zephray/Sharket/pcb/mainboard/pcb.kicad_pcb

## KiCad design pcb/mainboard/pcb.kicad_pcb (2023-03-07)

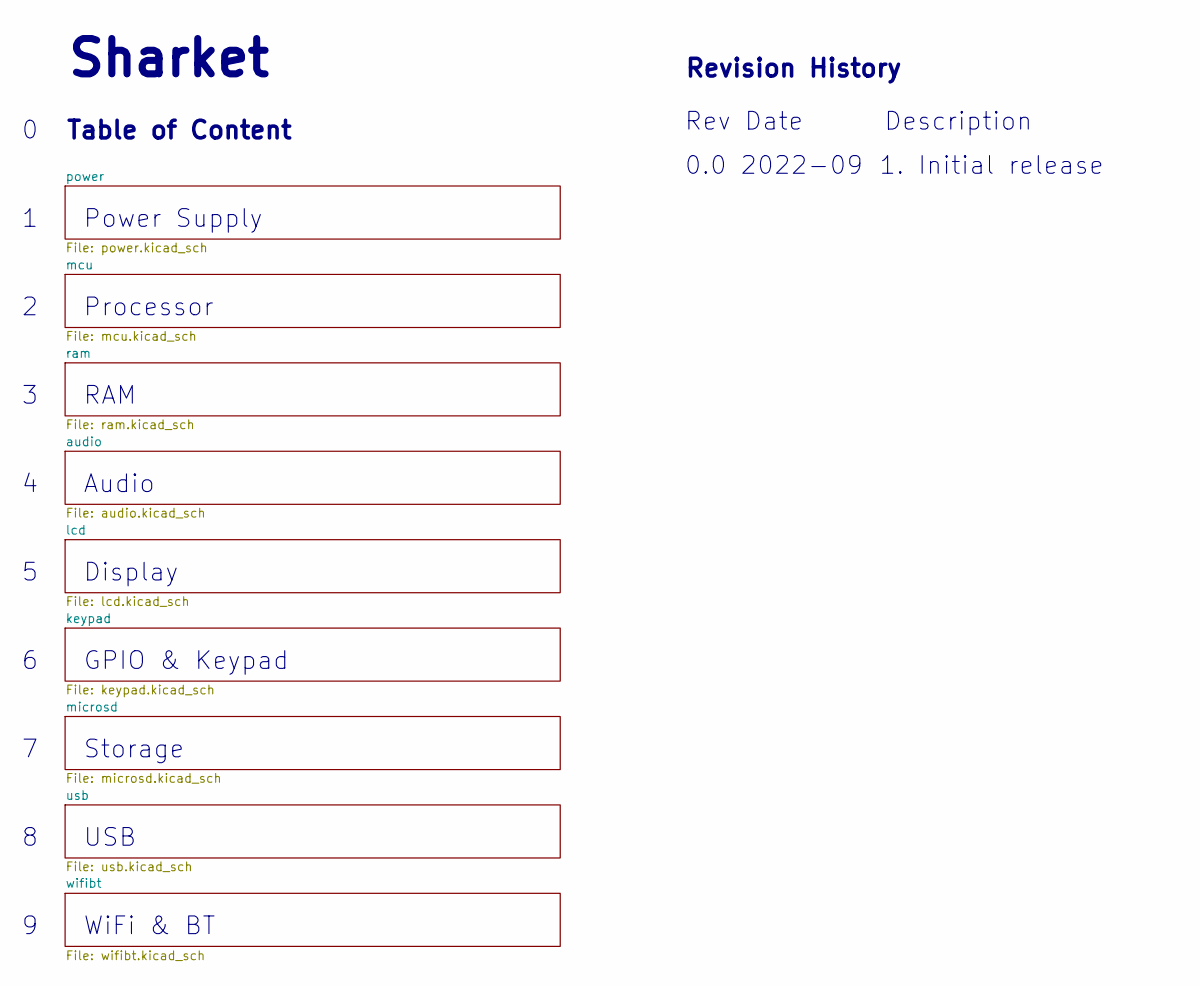
[picture p1: schematic pcb.kicad_sch, Sharket]

Notes on the sheet:
Storage
WiFi & BT
0.0 2022-09
Processor
Display
Revision History
Power Supply
Sharket
GPIO & Keypad
USB
Table of Content
RAM
Rev Date Description
Audio
1. Initial release

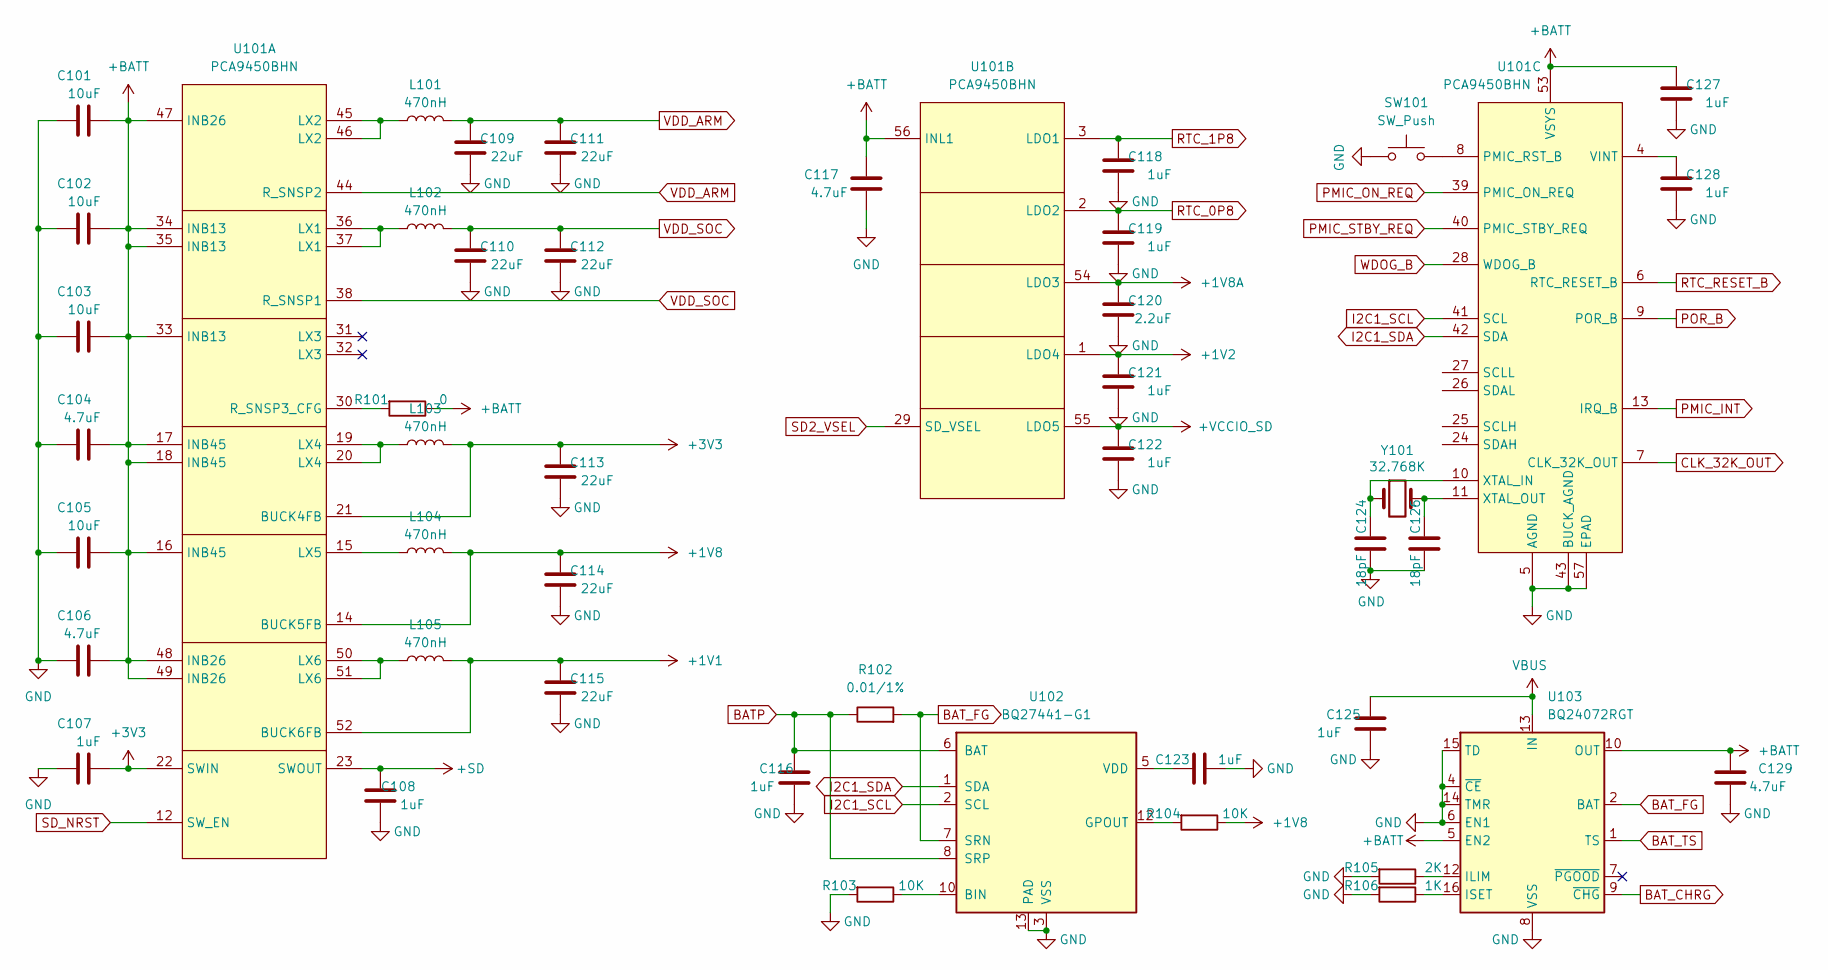
[picture p2: schematic power.kicad_sch, Sharket]

Parts:
C101, C102, C103, C105: 10uF; C_0603_1608Metric
C104, C106, C117, C129: 4.7uF; C_0402_1005Metric
C107, C108, C116, C123: 1uF; C_0402_1005Metric
C109, C110, C111, C112, C113, C114, C115: 22uF; C_0603_1608Metric
C118, C119, C121, C122, C125, C127, C128: 1uF; C_0201_0603Metric
C120: 2.2uF; C_0402_1005Metric
C124, C126: 18pF; C_0402_1005Metric
L101, L102, L103, L104, L105: 470nH; L_1008_2520Metric
R101: 0; R_0402_1005Metric
R102: 0.01/1%; R_0603_1608Metric
R103, R104: 10K; R_0402_1005Metric
R105: 2K; R_0402_1005Metric
R106: 1K; R_0402_1005Metric
SW101: SW_Push; SW_SPST_SKQG_WithStem
U101: PCA9450BHN; QFN-56_EP_7x7_Pitch0.4mm
U102: BQ27441-G1; Texas_S-PDSO-N12
U103: BQ24072RGT; VQFN-16-1EP_3x3mm_P0.5mm_EP1.6x1.6mm
Y101: 32.768K; Crystal_SMD_TXC_9HT11-2Pin_2.0x1.2mm_HandSoldering

Connections:
+1V1: C115.2, L105.2, U101.52 (BUCK6FB); also elsewhere on the board
+1V2: C121.2, U101.1 (LDO4); also elsewhere on the board
+1V8: C114.2, L104.2, R104.1, U101.14 (BUCK5FB); also elsewhere on the board
+1V8A: C120.2, U101.54 (LDO3); also elsewhere on the board
+3V3: C107.2, C113.2, L103.2, U101.21 (BUCK4FB), U101.22 (SWIN); also elsewhere on the board
+BATT: C101.2, C102.2, C103.2, C104.2, C105.2, C106.2, C117.2, C127.2, C129.2, R101.1, U101.16 (INB45), U101.17 (INB45), U101.18 (INB45), U101.33 (INB13), U101.34 (INB13), U101.35 (INB13), U101.47 (INB26), U101.48 (INB26), U101.49 (INB26), U101.53 (VSYS), U101.56 (INL1), U103.5 (EN2), U103.10 (OUT), U103.11 (OUT); also elsewhere on the board
+SD: C108.2, U101.23 (SWOUT); also elsewhere on the board
+VCCIO_SD: C122.2, U101.55 (LDO5); also elsewhere on the board
BATP: C116.2, R102.1, U102.6 (BAT), U102.8 (SRP); also elsewhere on the board
BAT_CHRG: U103.9 (~CHG)
BAT_FG: R102.2, U102.7 (SRN), U103.2 (BAT), U103.3 (BAT)
BAT_TS: U103.1 (TS)
CLK_32K_OUT: U101.7 (CLK_32K_OUT); also elsewhere on the board
GND: C101.1, C102.1, C103.1, C104.1, C105.1, C106.1, C107.1, C108.1, C109.1, C110.1, C111.1, C112.1, C113.1, C114.1, C115.1, C116.1, C117.1, C118.1, C119.1, C120.1, C121.1, C122.1, C123.1, C124.1, C125.1, C126.1, C127.1, C128.1, C129.1, R103.2, R105.2, R106.2, SW101.1, U101.5 (AGND), U101.43 (BUCK_AGND), U101.57 (EPAD), U102.3 (VSS), U102.13 (PAD), U103.4 (~CE), U103.6 (EN1), U103.8 (VSS), U103.14 (TMR), U103.15 (TD), U103.17 (VSS); also elsewhere on the board
I2C1_SCL: U101.41 (SCL), U102.2 (SCL); also elsewhere on the board
I2C1_SDA: U101.42 (SDA), U102.1 (SDA); also elsewhere on the board
unnamed: L101.1, U101.45 (LX2), U101.46 (LX2)
unnamed: L102.1, U101.36 (LX1), U101.37 (LX1)
unnamed: L103.1, U101.19 (LX4), U101.20 (LX4)
unnamed: L105.1, U101.50 (LX6), U101.51 (LX6)
unnamed: L104.1, U101.15 (LX5)
unnamed: R101.2, U101.30 (R_SNSP3_CFG)
unnamed: SW101.2, U101.8 (PMIC_RST_B)
unnamed: C128.2, U101.4 (VINT)
unnamed: C124.2, U101.10 (XTAL_IN), Y101.1
unnamed: C126.2, U101.11 (XTAL_OUT), Y101.2
unnamed: R103.1, U102.10 (BIN)
unnamed: R104.2, U102.12 (GPOUT)
unnamed: C123.2, U102.5 (VDD)
unnamed: R105.1, U103.12 (ILIM)
unnamed: R106.1, U103.16 (ISET)
PMIC_INT: U101.13 (IRQ_B); also elsewhere on the board
PMIC_ON_REQ: U101.39 (PMIC_ON_REQ); also elsewhere on the board
PMIC_STBY_REQ: U101.40 (PMIC_STBY_REQ); also elsewhere on the board
POR_B: U101.9 (POR_B); also elsewhere on the board
RTC_0P8: C119.2, U101.2 (LDO2); also elsewhere on the board
RTC_1P8: C118.2, U101.3 (LDO1); also elsewhere on the board
RTC_RESET_B: U101.6 (RTC_RESET_B); also elsewhere on the board
SD2_VSEL: U101.29 (SD_VSEL); also elsewhere on the board
SD_NRST: U101.12 (SW_EN); also elsewhere on the board
VBUS: C125.2, U103.13 (IN); also elsewhere on the board
VDD_ARM: C109.2, C111.2, L101.2, U101.44 (R_SNSP2); also elsewhere on the board
VDD_SOC: C110.2, C112.2, L102.2, U101.38 (R_SNSP1); also elsewhere on the board
WDOG_B: U101.28 (WDOG_B); also elsewhere on the board

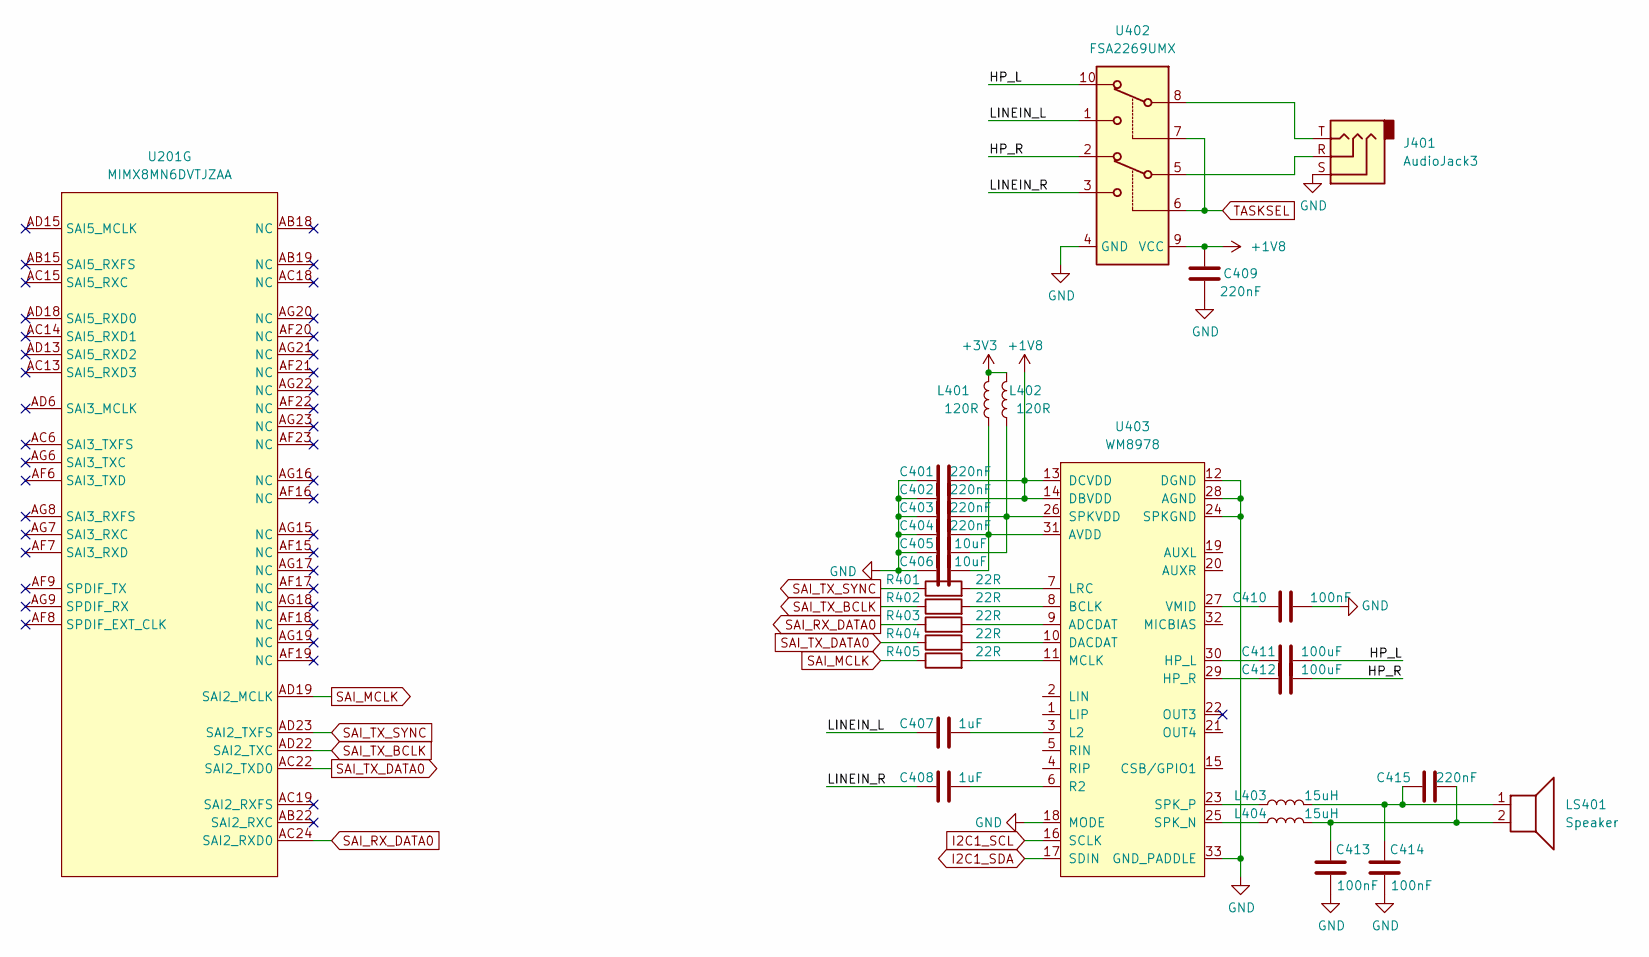
[picture p3: schematic audio.kicad_sch, Sharket]

Parts:
C401, C402, C403, C404, C409, C415: 220nF; C_0201_0603Metric; LCSC C880414
C405, C406: 10uF; C_0402_1005Metric; LCSC C105490
C407, C408: 1uF; C_0402_1005Metric; LCSC C157353
C410, C413, C414: 100nF; C_0201_0603Metric; LCSC C56392
C411, C412: 100uF; C_1206_3216Metric; LCSC C178304
J401: AudioJack3; PJ-208
L401, L402: 120R; L_0603_1608Metric; LCSC C76892
L403, L404: 15uH; L_0603_1608Metric; LCSC C486329
LS401: Speaker; Buzzer_CUI_CPT-9019S-SMT
R401, R402, R403, R404, R405: 22R; R_0402_1005Metric; LCSC C93929
U201: MIMX8MN6DVTJZAA; BGA-486_27x27_14.0x14.0mm
U402: FSA2269UMX; UQFN-10_1.4x1.8mm_P0.4mm
U403: WM8978; QFN-32-1EP_5x5mm_P0.5mm_EP3.45x3.45mm_ThermalVias

Connections:
+1V8: C401.1, C402.1, C409.1, U402.9 (VCC), U403.13 (DCVDD), U403.14 (DBVDD); also elsewhere on the board
+3V3: L401.2, L402.2; also elsewhere on the board
/audio/HP_L: C411.2, U402.10
/audio/HP_R: C412.2, U402.2
/audio/LINEIN_L: C407.2, U402.1
/audio/LINEIN_R: C408.2, U402.3
GND: C401.2, C402.2, C403.2, C404.2, C405.2, C406.2, C409.2, C410.2, C413.1, C414.1, J401.S, U402.4 (GND), U403.12 (DGND), U403.18 (MODE), U403.24 (SPKGND), U403.28 (AGND), U403.33 (GND_PADDLE); also elsewhere on the board
I2C1_SCL: U403.16 (SCLK); also elsewhere on the board
I2C1_SDA: U403.17 (SDIN); also elsewhere on the board
unnamed: C413.2, C415.2, L404.2, LS401.2
unnamed: C414.2, C415.1, L403.2, LS401.1
unnamed: J401.R, U402.5
unnamed: J401.T, U402.8
unnamed: R403.2, U403.9 (ADCDAT)
unnamed: C404.1, C406.1, L401.1, U403.31 (AVDD)
unnamed: R402.2, U403.8 (BCLK)
unnamed: R404.2, U403.10 (DACDAT)
unnamed: C411.1, U403.30 (HP_L)
unnamed: C412.1, U403.29 (HP_R)
unnamed: C407.1, U403.3 (L2)
unnamed: R401.2, U403.7 (LRC)
unnamed: R405.2, U403.11 (MCLK)
unnamed: C408.1, U403.6 (R2)
unnamed: C403.1, C405.1, L402.1, U403.26 (SPKVDD)
unnamed: L404.1, U403.25 (SPK_N)
unnamed: L403.1, U403.23 (SPK_P)
unnamed: C410.1, U403.27 (VMID)
SAI_MCLK: R405.1, U201.AD19 (SAI2_MCLK)
SAI_RX_DATA0: R403.1, U201.AC24 (SAI2_RXD0)
SAI_TX_BCLK: R402.1, U201.AD22 (SAI2_TXC)
SAI_TX_DATA0: R404.1, U201.AC22 (SAI2_TXD0)
SAI_TX_SYNC: R401.1, U201.AD23 (SAI2_TXFS)
TASKSEL: U402.6, U402.7; also elsewhere on the board

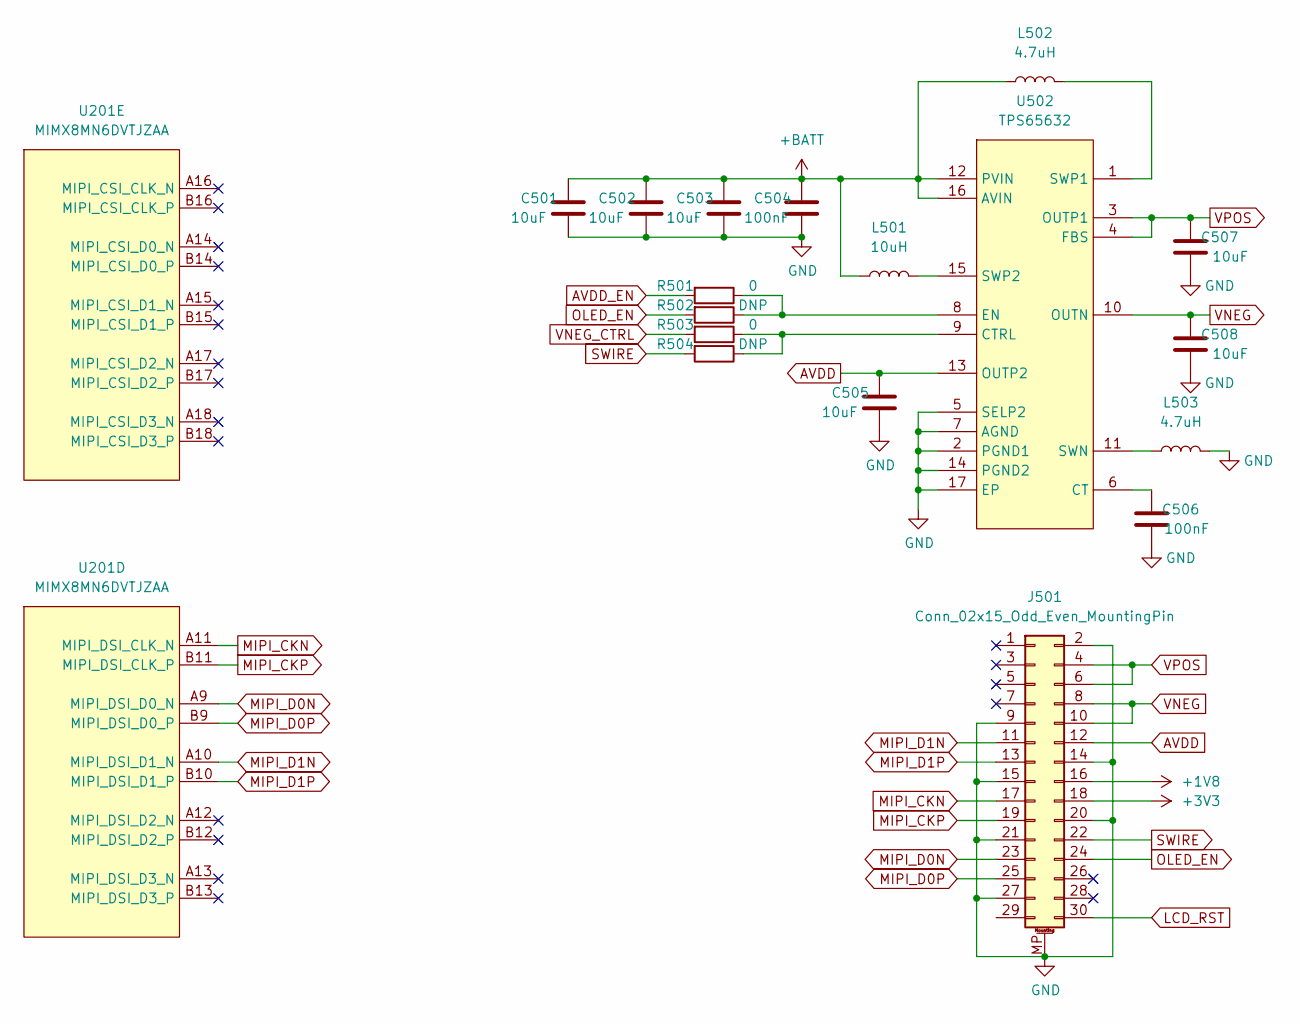
[picture p4: schematic lcd.kicad_sch, Sharket]

Parts:
C501, C502, C503, C505, C507, C508: 10uF; C_0603_1608Metric
C504, C506: 100nF; C_0201_0603Metric
J501: Conn_02x15_Odd_Even_MountingPin; 505270-3012
L501: 10uH; L_1008_2520Metric
L502, L503: 4.7uH; L_1008_2520Metric
R501, R503: 0; R_0402_1005Metric
R502, R504: DNP; R_0402_1005Metric
U201: MIMX8MN6DVTJZAA; BGA-486_27x27_14.0x14.0mm
U502: TPS65632; QFN-16-1EP_3x3mm_P0.5mm_EP1.7x1.7mm

Connections:
+1V8: J501.16; also elsewhere on the board
+3V3: J501.18; also elsewhere on the board
+BATT: C501.2, C502.2, C503.2, C504.2, L501.1, L502.1, U502.12 (PVIN), U502.16 (AVIN); also elsewhere on the board
AVDD: C505.2, J501.12, U502.13 (OUTP2)
AVDD_EN: R501.2; also elsewhere on the board
GND: C501.1, C502.1, C503.1, C504.1, C505.1, C506.1, C507.1, C508.1, J501.2, J501.9, J501.14, J501.15, J501.20, J501.21, J501.27, J501.MP (MountPin), L503.2, U502.2 (PGND1), U502.5 (SELP2), U502.7 (AGND), U502.14 (PGND2), U502.17 (EP); also elsewhere on the board
LCD_RST: J501.30; also elsewhere on the board
MIPI_CKN: J501.17, U201.A11 (MIPI_DSI_CLK_N)
MIPI_CKP: J501.19, U201.B11 (MIPI_DSI_CLK_P)
MIPI_D0N: J501.23, U201.A9 (MIPI_DSI_D0_N)
MIPI_D0P: J501.25, U201.B9 (MIPI_DSI_D0_P)
MIPI_D1N: J501.11, U201.A10 (MIPI_DSI_D1_N)
MIPI_D1P: J501.13, U201.B10 (MIPI_DSI_D1_P)
unnamed: C506.2, U502.6 (CT)
unnamed: R503.1, R504.1, U502.9 (CTRL)
unnamed: R501.1, R502.1, U502.8 (EN)
unnamed: L503.1, U502.11 (SWN)
unnamed: L502.2, U502.1 (SWP1)
unnamed: L501.2, U502.15 (SWP2)
OLED_EN: J501.24, R502.2
SWIRE: J501.22, R504.2
VNEG: C508.2, J501.8, J501.10, U502.10 (OUTN)
VNEG_CTRL: R503.2; also elsewhere on the board
VPOS: C507.2, J501.4, J501.6, U502.3 (OUTP1), U502.4 (FBS)

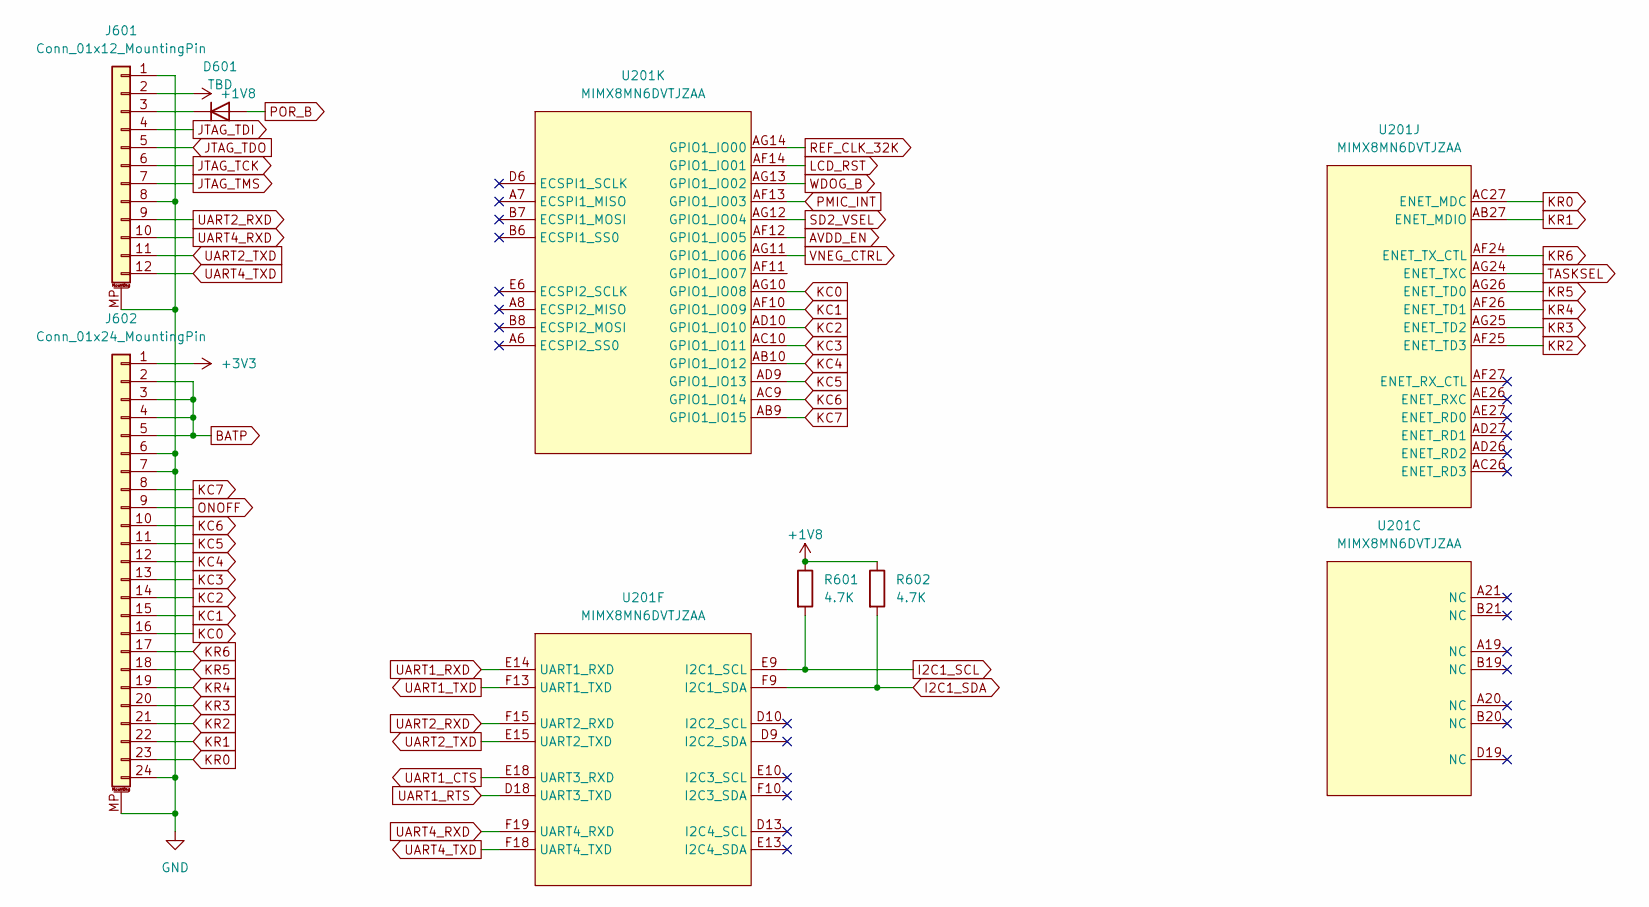
[picture p5: schematic keypad.kicad_sch, Sharket]

Parts:
D601: TBD; D_SOD-323
J601: Conn_01x12_MountingPin; TE_1-1734839-2_1x12-1MP_P0.5mm_Horizontal
J602: Conn_01x24_MountingPin; TE_2-1734839-4_1x24-1MP_P0.5mm_Horizontal
R601, R602: 4.7K; R_0402_1005Metric
U201: MIMX8MN6DVTJZAA; BGA-486_27x27_14.0x14.0mm

Connections:
+1V8: J601.2, R601.1, R602.1; also elsewhere on the board
+3V3: J602.1; also elsewhere on the board
AVDD_EN: U201.AF12 (GPIO1_IO05); also elsewhere on the board
BATP: J602.2, J602.3, J602.4, J602.5; also elsewhere on the board
GND: J601.1, J601.8, J601.MP (MountPin), J602.6, J602.7, J602.24, J602.MP (MountPin); also elsewhere on the board
I2C1_SCL: R601.2, U201.E9 (I2C1_SCL); also elsewhere on the board
I2C1_SDA: R602.2, U201.F9 (I2C1_SDA); also elsewhere on the board
JTAG_TCK: J601.6; also elsewhere on the board
JTAG_TDI: J601.4; also elsewhere on the board
JTAG_TDO: J601.5; also elsewhere on the board
JTAG_TMS: J601.7; also elsewhere on the board
KC0: J602.16, U201.AG10 (GPIO1_IO08)
KC1: J602.15, U201.AF10 (GPIO1_IO09)
KC2: J602.14, U201.AD10 (GPIO1_IO10)
KC3: J602.13, U201.AC10 (GPIO1_IO11)
KC4: J602.12, U201.AB10 (GPIO1_IO12)
KC5: J602.11, U201.AD9 (GPIO1_IO13)
KC6: J602.10, U201.AC9 (GPIO1_IO14)
KC7: J602.8, U201.AB9 (GPIO1_IO15)
KR0: J602.23, U201.AC27 (ENET_MDC)
KR1: J602.22, U201.AB27 (ENET_MDIO)
KR2: J602.21, U201.AF25 (ENET_TD3)
KR3: J602.20, U201.AG25 (ENET_TD2)
KR4: J602.19, U201.AF26 (ENET_TD1)
KR5: J602.18, U201.AG26 (ENET_TD0)
KR6: J602.17, U201.AF24 (ENET_TX_CTL)
LCD_RST: U201.AF14 (GPIO1_IO01); also elsewhere on the board
unnamed: D601.1 (K), J601.3
ONOFF: J602.9; also elsewhere on the board
PMIC_INT: U201.AF13 (GPIO1_IO03); also elsewhere on the board
POR_B: D601.2 (A); also elsewhere on the board
REF_CLK_32K: U201.AG14 (GPIO1_IO00); also elsewhere on the board
SD2_VSEL: U201.AG12 (GPIO1_IO04); also elsewhere on the board
TASKSEL: U201.AG24 (ENET_TXC); also elsewhere on the board
UART1_CTS: U201.E18 (UART3_RXD); also elsewhere on the board
UART1_RTS: U201.D18 (UART3_TXD); also elsewhere on the board
UART1_RXD: U201.E14 (UART1_RXD); also elsewhere on the board
UART1_TXD: U201.F13 (UART1_TXD); also elsewhere on the board
UART2_RXD: J601.9, U201.F15 (UART2_RXD)
UART2_TXD: J601.11, U201.E15 (UART2_TXD)
UART4_RXD: J601.10, U201.F19 (UART4_RXD)
UART4_TXD: J601.12, U201.F18 (UART4_TXD)
VNEG_CTRL: U201.AG11 (GPIO1_IO06); also elsewhere on the board
WDOG_B: U201.AG13 (GPIO1_IO02); also elsewhere on the board

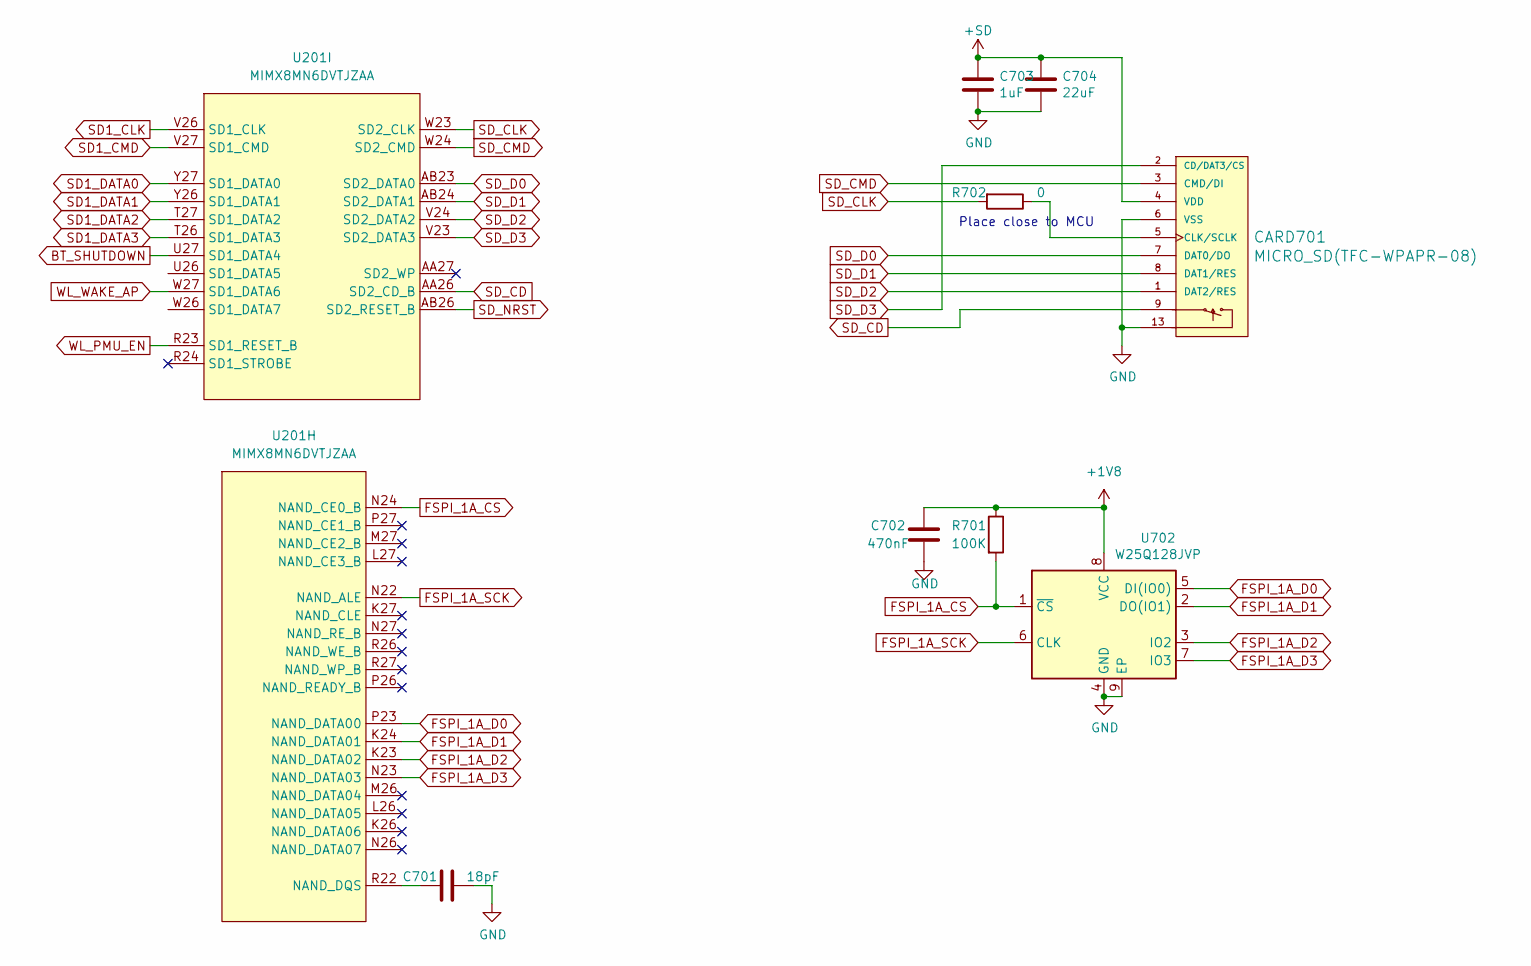
[picture p6: schematic microsd.kicad_sch, Sharket]

Parts:
C701: 18pF; C_0402_1005Metric
C702: 470nF; C_0402_1005Metric
C703: 1uF; C_0402_1005Metric
C704: 22uF; C_0603_1608Metric
CARD701: MICRO_SD(TFC-WPAPR-08); TFC-WPAPR-08
R701: 100K; R_0402_1005Metric
R702: 0; R_0402_1005Metric
U201: MIMX8MN6DVTJZAA; BGA-486_27x27_14.0x14.0mm
U702: W25Q128JVP; WSON-8-1EP_6x5mm_P1.27mm_EP3.4x4.3mm

Connections:
+1V8: C702.2, R701.1, U702.8 (VCC); also elsewhere on the board
+SD: C703.1, C704.1, CARD701.4 (VDD); also elsewhere on the board
BT_SHUTDOWN: U201.U27 (SD1_DATA4); also elsewhere on the board
FSPI_1A_CS: R701.2, U201.N24 (NAND_CE0_B), U702.1 (~CS)
FSPI_1A_D0: U201.P23 (NAND_DATA00), U702.5 (DI(IO0))
FSPI_1A_D1: U201.K24 (NAND_DATA01), U702.2 (DO(IO1))
FSPI_1A_D2: U201.K23 (NAND_DATA02), U702.3 (IO2)
FSPI_1A_D3: U201.N23 (NAND_DATA03), U702.7 (IO3)
FSPI_1A_SCK: U201.N22 (NAND_ALE), U702.6 (CLK)
GND: C701.1, C702.1, C703.2, C704.2, CARD701.6 (VSS), CARD701.10, CARD701.11, CARD701.12, CARD701.13, U702.4 (GND), U702.9 (EP); also elsewhere on the board
unnamed: CARD701.5 (CLK/SCLK), R702.1
unnamed: C701.2, U201.R22 (NAND_DQS)
SD1_CLK: U201.V26 (SD1_CLK); also elsewhere on the board
SD1_CMD: U201.V27 (SD1_CMD); also elsewhere on the board
SD1_DATA0: U201.Y27 (SD1_DATA0); also elsewhere on the board
SD1_DATA1: U201.Y26 (SD1_DATA1); also elsewhere on the board
SD1_DATA2: U201.T27 (SD1_DATA2); also elsewhere on the board
SD1_DATA3: U201.T26 (SD1_DATA3); also elsewhere on the board
SD_CD: CARD701.9, U201.AA26 (SD2_CD_B)
SD_CLK: R702.2, U201.W23 (SD2_CLK)
SD_CMD: CARD701.3 (CMD/DI), U201.W24 (SD2_CMD)
SD_D0: CARD701.7 (DAT0/DO), U201.AB23 (SD2_DATA0)
SD_D1: CARD701.8 (DAT1/RES), U201.AB24 (SD2_DATA1)
SD_D2: CARD701.1 (DAT2/RES), U201.V24 (SD2_DATA2)
SD_D3: CARD701.2 (CD/DAT3/CS), U201.V23 (SD2_DATA3)
SD_NRST: U201.AB26 (SD2_RESET_B); also elsewhere on the board
WL_PMU_EN: U201.R23 (SD1_RESET_B); also elsewhere on the board
WL_WAKE_AP: U201.W27 (SD1_DATA6); also elsewhere on the board

Notes on the sheet:
Place close to MCU

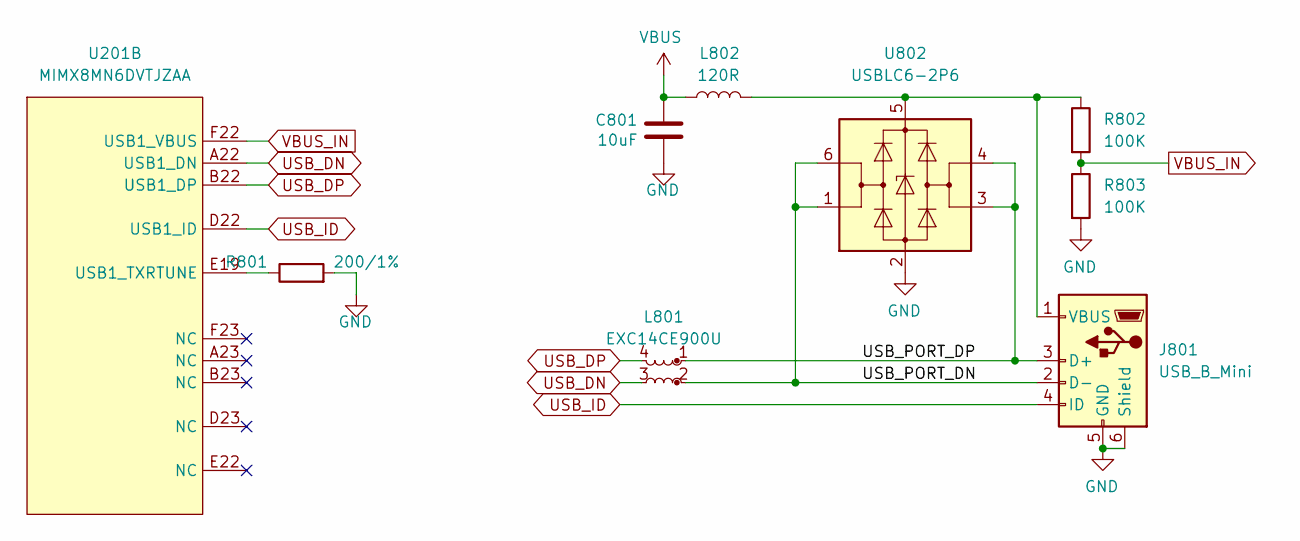
[picture p7: schematic usb.kicad_sch, Sharket]

Parts:
C801: 10uF; C_0402_1005Metric
J801: USB_B_Mini; USB_Mini-B_Wuerth_65100516121_Horizontal
L801: EXC14CE900U; L_CommonModeChoke_Panasonic_EXC14CE
L802: 120R; L_0603_1608Metric
R801: 200/1%; R_0402_1005Metric
R802, R803: 100K; R_0402_1005Metric
U201: MIMX8MN6DVTJZAA; BGA-486_27x27_14.0x14.0mm
U802: USBLC6-2P6; SOT-666

Connections:
/usb/USB_PORT_DN: J801.2 (D-), L801.2, U802.1 (I/O1), U802.6 (I/O1)
/usb/USB_PORT_DP: J801.3 (D+), L801.1, U802.3 (I/O2), U802.4 (I/O2)
GND: C801.2, J801.5 (GND), J801.6 (Shield), R801.2, R803.2, U802.2 (GND); also elsewhere on the board
unnamed: J801.1 (VBUS), L802.2, R802.1, U802.5 (VBUS)
unnamed: R801.1, U201.E19 (USB1_TXRTUNE)
USB_DN: L801.3, U201.A22 (USB1_DN)
USB_DP: L801.4, U201.B22 (USB1_DP)
USB_ID: J801.4 (ID), U201.D22 (USB1_ID)
VBUS: C801.1, L802.1; also elsewhere on the board
VBUS_IN: R802.2, R803.1, U201.F22 (USB1_VBUS)

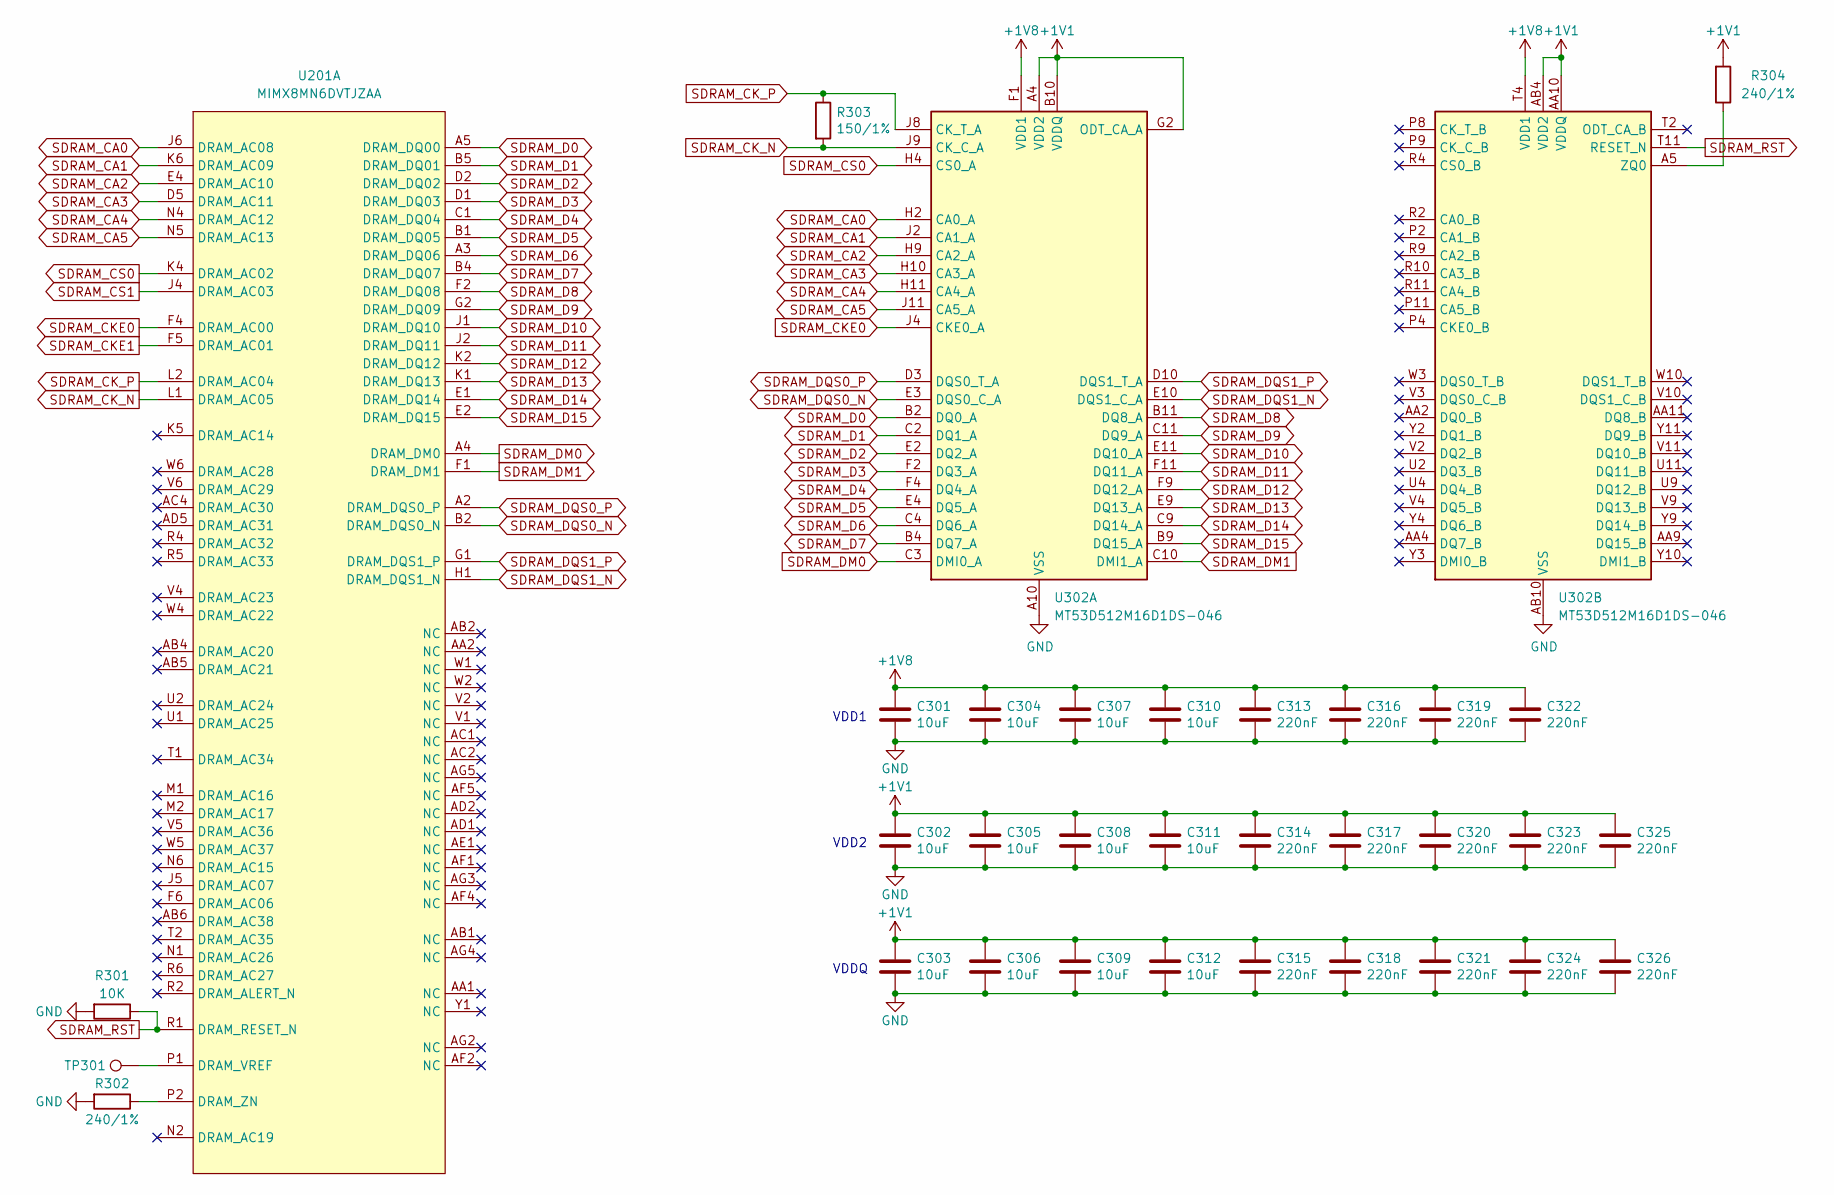
[picture p8: schematic ram.kicad_sch, Sharket]

Parts:
C301, C302, C303, C304, C305, C306, C307, C308, C309, C310, C311, C312: 10uF; C_0402_1005Metric
C313, C314, C315, C316, C317, C318, C319, C320, C321, C322, C323, C324, C325, C326: 220nF; C_0201_0603Metric
R301: 10K; R_0402_1005Metric
R302, R304: 240/1%; R_0402_1005Metric
R303: 150/1%; R_0402_1005Metric
TP301: TestPoint; TestPoint_Pad_D1.0mm
U201: MIMX8MN6DVTJZAA; BGA-486_27x27_14.0x14.0mm
U302: MT53D512M16D1DS-046; BGA-200_10.0x14.5mm_Layout12x22_P0.80x0.65mm_B0.3mm

Connections:
+1V1: C302.1, C303.1, C305.1, C306.1, C308.1, C309.1, C311.1, C312.1, C314.1, C315.1, C317.1, C318.1, C320.1, C321.1, C323.1, C324.1, C325.1, C326.1, R304.2, U302.A4 (VDD2), U302.A9 (VDD2), U302.AA3 (VDDQ), U302.AA5 (VDDQ), U302.AA8 (VDDQ), U302.AA10 (VDDQ), U302.AB4 (VDD2), U302.AB9 (VDD2), U302.B3 (VDDQ), U302.B5 (VDDQ), U302.B8 (VDDQ), U302.B10 (VDDQ), U302.D1 (VDDQ), U302.D5 (VDDQ), U302.D8 (VDDQ), U302.D12 (VDDQ), U302.F3 (VDDQ), U302.F5 (VDD2), U302.F8 (VDD2), U302.F10 (VDDQ), U302.G2 (ODT_CA_A), U302.H1 (VDD2), U302.H5 (VDD2), U302.H8 (VDD2), U302.H12 (VDD2), U302.K1 (VDD2), U302.K3 (VDD2), U302.K10 (VDD2), U302.K12 (VDD2), U302.N1 (VDD2), U302.N3 (VDD2), U302.N10 (VDD2), U302.N12 (VDD2), U302.R1 (VDD2), U302.R5 (VDD2), U302.R8 (VDD2), U302.R12 (VDD2), U302.U3 (VDDQ), U302.U5 (VDD2), U302.U8 (VDD2), U302.U10 (VDDQ), U302.W1 (VDDQ), U302.W5 (VDDQ), U302.W8 (VDDQ), U302.W12 (VDDQ); also elsewhere on the board
+1V8: C301.1, C304.1, C307.1, C310.1, C313.1, C316.1, C319.1, C322.1, U302.F1 (VDD1), U302.F12 (VDD1), U302.G4 (VDD1), U302.G9 (VDD1), U302.T4 (VDD1), U302.T9 (VDD1), U302.U1 (VDD1), U302.U12 (VDD1); also elsewhere on the board
GND: C301.2, C302.2, C303.2, C304.2, C305.2, C306.2, C307.2, C308.2, C309.2, C310.2, C311.2, C312.2, C313.2, C314.2, C315.2, C316.2, C317.2, C318.2, C319.2, C320.2, C321.2, C322.2, C323.2, C324.2, C325.2, C326.2, R301.2, R302.2, U302.A3 (VSS), U302.A10 (VSS), U302.AB3 (VSS), U302.AB5 (VSS), U302.AB8 (VSS), U302.AB10 (VSS), U302.C1 (VSS), U302.C5 (VSS), U302.C8 (VSS), U302.C12 (VSS), U302.D2 (VSS), U302.D4 (VSS), U302.D9 (VSS), U302.D11 (VSS), U302.E1 (VSS), U302.E5 (VSS), U302.E8 (VSS), U302.E12 (VSS), U302.G1 (VSS), U302.G3 (VSS), U302.G5 (VSS), U302.G8 (VSS), U302.G10 (VSS), U302.G12 (VSS), U302.J1 (VSS), U302.J3 (VSS), U302.J10 (VSS), U302.J12 (VSS), U302.K2 (VSS), U302.K4 (VSS), U302.K9 (VSS), U302.K11 (VSS), U302.N2 (VSS), U302.N4 (VSS), U302.N9 (VSS), U302.N11 (VSS), U302.P1 (VSS), U302.P3 (VSS), U302.P10 (VSS), U302.P12 (VSS), U302.T1 (VSS), U302.T3 (VSS), U302.T5 (VSS), U302.T8 (VSS), U302.T10 (VSS), U302.T12 (VSS), U302.V1 (VSS), U302.V5 (VSS), U302.V8 (VSS), U302.V12 (VSS), U302.W2 (VSS), U302.W4 (VSS), U302.W9 (VSS), U302.W11 (VSS), U302.Y1 (VSS), U302.Y5 (VSS), U302.Y8 (VSS), U302.Y12 (VSS); also elsewhere on the board
unnamed: TP301.1, U201.P1 (DRAM_VREF)
unnamed: R302.1, U201.P2 (DRAM_ZN)
unnamed: R304.1, U302.A5 (ZQ0)
SDRAM_CA0: U201.J6 (DRAM_AC08), U302.H2 (CA0_A)
SDRAM_CA1: U201.K6 (DRAM_AC09), U302.J2 (CA1_A)
SDRAM_CA2: U201.E4 (DRAM_AC10), U302.H9 (CA2_A)
SDRAM_CA3: U201.D5 (DRAM_AC11), U302.H10 (CA3_A)
SDRAM_CA4: U201.N4 (DRAM_AC12), U302.H11 (CA4_A)
SDRAM_CA5: U201.N5 (DRAM_AC13), U302.J11 (CA5_A)
SDRAM_CKE0: U201.F4 (DRAM_AC00), U302.J4 (CKE0_A)
SDRAM_CKE1: U201.F5 (DRAM_AC01)
SDRAM_CK_N: R303.2, U201.L1 (DRAM_AC05), U302.J9 (CK_C_A)
SDRAM_CK_P: R303.1, U201.L2 (DRAM_AC04), U302.J8 (CK_T_A)
SDRAM_CS0: U201.K4 (DRAM_AC02), U302.H4 (CS0_A)
SDRAM_CS1: U201.J4 (DRAM_AC03)
SDRAM_D0: U201.A5 (DRAM_DQ00), U302.B2 (DQ0_A)
SDRAM_D1: U201.B5 (DRAM_DQ01), U302.C2 (DQ1_A)
SDRAM_D2: U201.D2 (DRAM_DQ02), U302.E2 (DQ2_A)
SDRAM_D3: U201.D1 (DRAM_DQ03), U302.F2 (DQ3_A)
SDRAM_D4: U201.C1 (DRAM_DQ04), U302.F4 (DQ4_A)
SDRAM_D5: U201.B1 (DRAM_DQ05), U302.E4 (DQ5_A)
SDRAM_D6: U201.A3 (DRAM_DQ06), U302.C4 (DQ6_A)
SDRAM_D7: U201.B4 (DRAM_DQ07), U302.B4 (DQ7_A)
SDRAM_D8: U201.F2 (DRAM_DQ08), U302.B11 (DQ8_A)
SDRAM_D9: U201.G2 (DRAM_DQ09), U302.C11 (DQ9_A)
SDRAM_D10: U201.J1 (DRAM_DQ10), U302.E11 (DQ10_A)
SDRAM_D11: U201.J2 (DRAM_DQ11), U302.F11 (DQ11_A)
SDRAM_D12: U201.K2 (DRAM_DQ12), U302.F9 (DQ12_A)
SDRAM_D13: U201.K1 (DRAM_DQ13), U302.E9 (DQ13_A)
SDRAM_D14: U201.E1 (DRAM_DQ14), U302.C9 (DQ14_A)
SDRAM_D15: U201.E2 (DRAM_DQ15), U302.B9 (DQ15_A)
SDRAM_DM0: U201.A4 (DRAM_DM0), U302.C3 (DMI0_A)
SDRAM_DM1: U201.F1 (DRAM_DM1), U302.C10 (DMI1_A)
SDRAM_DQS0_N: U201.B2 (DRAM_DQS0_N), U302.E3 (DQS0_C_A)
SDRAM_DQS0_P: U201.A2 (DRAM_DQS0_P), U302.D3 (DQS0_T_A)
SDRAM_DQS1_N: U201.H1 (DRAM_DQS1_N), U302.E10 (DQS1_C_A)
SDRAM_DQS1_P: U201.G1 (DRAM_DQS1_P), U302.D10 (DQS1_T_A)
SDRAM_RST: R301.1, U201.R1 (DRAM_RESET_N), U302.T11 (RESET_N)

Notes on the sheet:
VDDQ
VDD1
VDD2
