zephray/Sharket/pcb/mainboard/pcb.kicad_pcb

## KiCad design pcb/mainboard/pcb.kicad_pcb (continued)

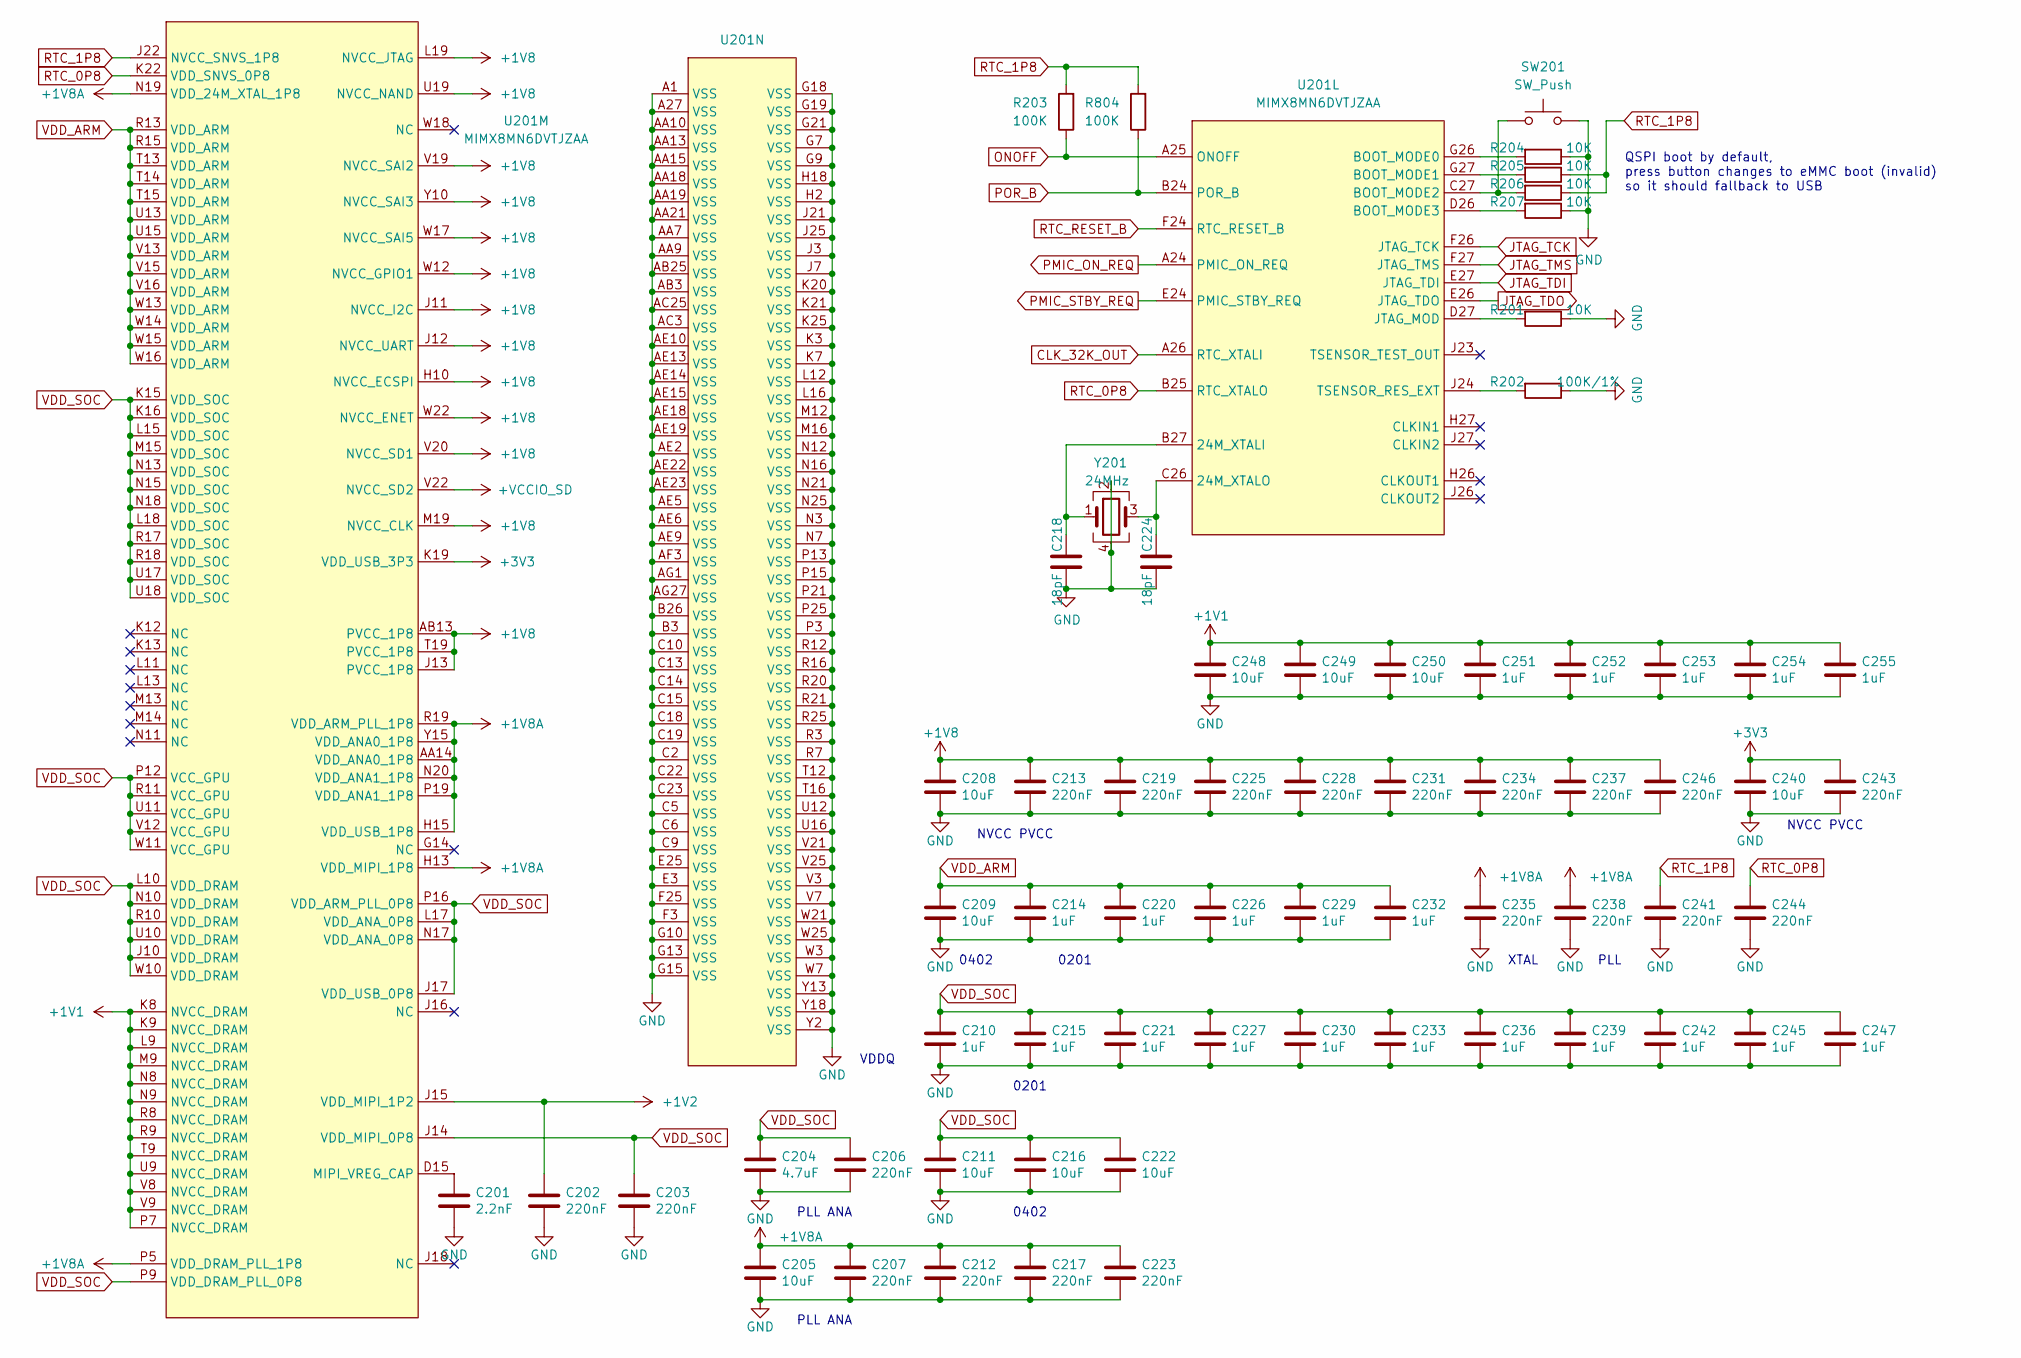
[picture p9: schematic mcu.kicad_sch, Sharket]

Parts:
C201: 2.2nF; C_0402_1005Metric
C202, C203, C206, C207, C212, C213, C217, C219, C223, C225, C228, C231, C234, C235, C237, C238, C241, C243, C244, C246: 220nF; C_0201_0603Metric
C204: 4.7uF; C_0402_1005Metric
C205, C208, C209, C211, C216, C222, C240, C248, C249, C250: 10uF; C_0402_1005Metric
C210, C214, C215, C220, C221, C226, C227, C229, C230, C232, C233, C236, C239, C242, C245, C247, C251, C252, C253, C254, C255: 1uF; C_0201_0603Metric
C218, C224: 18pF; C_0402_1005Metric
R201, R204, R205, R206, R207: 10K; R_0402_1005Metric
R202: 100K/1%; R_0402_1005Metric
R203, R804: 100K; R_0402_1005Metric; LCSC C93929
SW201: SW_Push; SW_SPST_SKQG_WithStem
U201: MIMX8MN6DVTJZAA; BGA-486_27x27_14.0x14.0mm
Y201: 24MHz; Oscillator_SMD_Abracon_ASE-4Pin_3.2x2.5mm

Connections:
+1V1: C248.1, C249.1, C250.1, C251.1, C252.1, C253.1, C254.1, C255.1, U201.K8 (NVCC_DRAM), U201.K9 (NVCC_DRAM), U201.L9 (NVCC_DRAM), U201.M9 (NVCC_DRAM), U201.N8 (NVCC_DRAM), U201.N9 (NVCC_DRAM), U201.P7 (NVCC_DRAM), U201.R8 (NVCC_DRAM), U201.R9 (NVCC_DRAM), U201.T9 (NVCC_DRAM), U201.U9 (NVCC_DRAM), U201.V8 (NVCC_DRAM), U201.V9 (NVCC_DRAM); also elsewhere on the board
+1V2: C202.1, U201.J15 (VDD_MIPI_1P2); also elsewhere on the board
+1V8: C208.1, C213.1, C219.1, C225.1, C228.1, C231.1, C234.1, C237.1, C246.1, U201.AB13 (PVCC_1P8), U201.H10 (NVCC_ECSPI), U201.J11 (NVCC_I2C), U201.J12 (NVCC_UART), U201.J13 (PVCC_1P8), U201.L19 (NVCC_JTAG), U201.M19 (NVCC_CLK), U201.T19 (PVCC_1P8), U201.U19 (NVCC_NAND), U201.V19 (NVCC_SAI2), U201.V20 (NVCC_SD1), U201.W12 (NVCC_GPIO1), U201.W17 (NVCC_SAI5), U201.W22 (NVCC_ENET), U201.Y10 (NVCC_SAI3); also elsewhere on the board
+1V8A: C205.1, C207.1, C212.1, C217.1, C223.1, C235.1, C238.1, U201.AA14 (VDD_ANA0_1P8), U201.H13 (VDD_MIPI_1P8), U201.H15 (VDD_USB_1P8), U201.N19 (VDD_24M_XTAL_1P8), U201.N20 (VDD_ANA1_1P8), U201.P5 (VDD_DRAM_PLL_1P8), U201.P19 (VDD_ANA1_1P8), U201.R19 (VDD_ARM_PLL_1P8), U201.Y15 (VDD_ANA0_1P8); also elsewhere on the board
+3V3: C240.1, C243.1, U201.K19 (VDD_USB_3P3); also elsewhere on the board
+VCCIO_SD: U201.V22 (NVCC_SD2); also elsewhere on the board
CLK_32K_OUT: U201.A26 (RTC_XTALI); also elsewhere on the board
GND: C201.2, C202.2, C203.2, C204.2, C205.2, C206.2, C207.2, C208.2, C209.2, C210.2, C211.2, C212.2, C213.2, C214.2, C215.2, C216.2, C217.2, C218.2, C219.2, C220.2, C221.2, C222.2, C223.2, C224.2, C225.2, C226.2, C227.2, C228.2, C229.2, C230.2, C231.2, C232.2, C233.2, C234.2, C235.2, C236.2, C237.2, C238.2, C239.2, C240.2, C241.2, C242.2, C243.2, C244.2, C245.2, C246.2, C247.2, C248.2, C249.2, C250.2, C251.2, C252.2, C253.2, C254.2, C255.2, R201.1, R202.1, R204.1, R207.1, SW201.2, U201.A1 (VSS), U201.A27 (VSS), U201.AA7 (VSS), U201.AA9 (VSS), U201.AA10 (VSS), U201.AA13 (VSS), U201.AA15 (VSS), U201.AA18 (VSS), U201.AA19 (VSS), U201.AA21 (VSS), U201.AB3 (VSS), U201.AB25 (VSS), U201.AC3 (VSS), U201.AC25 (VSS), U201.AE2 (VSS), U201.AE5 (VSS), U201.AE6 (VSS), U201.AE9 (VSS), U201.AE10 (VSS), U201.AE13 (VSS), U201.AE14 (VSS), U201.AE15 (VSS), U201.AE18 (VSS), U201.AE19 (VSS), U201.AE22 (VSS), U201.AE23 (VSS), U201.AF3 (VSS), U201.AG1 (VSS), U201.AG27 (VSS), U201.B3 (VSS), U201.B26 (VSS), U201.C2 (VSS), U201.C5 (VSS), U201.C6 (VSS), U201.C9 (VSS), U201.C10 (VSS), U201.C13 (VSS), U201.C14 (VSS), U201.C15 (VSS), U201.C18 (VSS), U201.C19 (VSS), U201.C22 (VSS), U201.C23 (VSS), U201.E3 (VSS), U201.E25 (VSS), U201.F3 (VSS), U201.F25 (VSS), U201.G7 (VSS), U201.G9 (VSS), U201.G10 (VSS), U201.G13 (VSS), U201.G15 (VSS), U201.G18 (VSS), U201.G19 (VSS), U201.G21 (VSS), U201.H2 (VSS), U201.H18 (VSS), U201.J3 (VSS), U201.J7 (VSS), U201.J21 (VSS), U201.J25 (VSS), U201.K3 (VSS), U201.K7 (VSS), U201.K20 (VSS), U201.K21 (VSS), U201.K25 (VSS), U201.L12 (VSS), U201.L16 (VSS), U201.M12 (VSS), U201.M16 (VSS), U201.N3 (VSS), U201.N7 (VSS), U201.N12 (VSS), U201.N16 (VSS), U201.N21 (VSS), U201.N25 (VSS), U201.P3 (VSS), U201.P13 (VSS), U201.P15 (VSS), U201.P21 (VSS), U201.P25 (VSS), U201.R3 (VSS), U201.R7 (VSS), U201.R12 (VSS), U201.R16 (VSS), U201.R20 (VSS), U201.R21 (VSS), U201.R25 (VSS), U201.T12 (VSS), U201.T16 (VSS), U201.U12 (VSS), U201.U16 (VSS), U201.V3 (VSS), U201.V7 (VSS), U201.V21 (VSS), U201.V25 (VSS), U201.W3 (VSS), U201.W7 (VSS), U201.W21 (VSS), U201.W25 (VSS), U201.Y2 (VSS), U201.Y13 (VSS), U201.Y18 (VSS), Y201.2, Y201.4; also elsewhere on the board
JTAG_TCK: U201.F26 (JTAG_TCK); also elsewhere on the board
JTAG_TDI: U201.E27 (JTAG_TDI); also elsewhere on the board
JTAG_TDO: U201.E26 (JTAG_TDO); also elsewhere on the board
JTAG_TMS: U201.F27 (JTAG_TMS); also elsewhere on the board
unnamed: C218.1, U201.B27 (24M_XTALI), Y201.1
unnamed: C224.1, U201.C26 (24M_XTALO), Y201.3
unnamed: R204.2, U201.G26 (BOOT_MODE0)
unnamed: R205.2, U201.G27 (BOOT_MODE1)
unnamed: R206.2, SW201.1, U201.C27 (BOOT_MODE2)
unnamed: R207.2, U201.D26 (BOOT_MODE3)
unnamed: R201.2, U201.D27 (JTAG_MOD)
unnamed: R202.2, U201.J24 (TSENSOR_RES_EXT)
unnamed: C201.1, U201.D15 (MIPI_VREG_CAP)
ONOFF: R203.1, U201.A25 (ONOFF); also elsewhere on the board
PMIC_ON_REQ: U201.A24 (PMIC_ON_REQ); also elsewhere on the board
PMIC_STBY_REQ: U201.E24 (PMIC_STBY_REQ); also elsewhere on the board
POR_B: R804.1, U201.B24 (POR_B); also elsewhere on the board
RTC_0P8: C244.1, U201.B25 (RTC_XTALO), U201.K22 (VDD_SNVS_0P8); also elsewhere on the board
RTC_1P8: C241.1, R203.2, R205.1, R206.1, R804.2, U201.J22 (NVCC_SNVS_1P8); also elsewhere on the board
RTC_RESET_B: U201.F24 (RTC_RESET_B); also elsewhere on the board
VDD_ARM: C209.1, C214.1, C220.1, C226.1, C229.1, C232.1, U201.R13 (VDD_ARM), U201.R15 (VDD_ARM), U201.T13 (VDD_ARM), U201.T14 (VDD_ARM), U201.T15 (VDD_ARM), U201.U13 (VDD_ARM), U201.U15 (VDD_ARM), U201.V13 (VDD_ARM), U201.V15 (VDD_ARM), U201.V16 (VDD_ARM), U201.W13 (VDD_ARM), U201.W14 (VDD_ARM), U201.W15 (VDD_ARM), U201.W16 (VDD_ARM); also elsewhere on the board
VDD_SOC: C203.1, C204.1, C206.1, C210.1, C211.1, C215.1, C216.1, C221.1, C222.1, C227.1, C230.1, C233.1, C236.1, C239.1, C242.1, C245.1, C247.1, U201.J10 (VDD_DRAM), U201.J14 (VDD_MIPI_0P8), U201.J17 (VDD_USB_0P8), U201.K15 (VDD_SOC), U201.K16 (VDD_SOC), U201.L10 (VDD_DRAM), U201.L15 (VDD_SOC), U201.L17 (VDD_ANA_0P8), U201.L18 (VDD_SOC), U201.M15 (VDD_SOC), U201.N10 (VDD_DRAM), U201.N13 (VDD_SOC), U201.N15 (VDD_SOC), U201.N17 (VDD_ANA_0P8), U201.N18 (VDD_SOC), U201.P9 (VDD_DRAM_PLL_0P8), U201.P12 (VCC_GPU), U201.P16 (VDD_ARM_PLL_0P8), U201.R10 (VDD_DRAM), U201.R11 (VCC_GPU), U201.R17 (VDD_SOC), U201.R18 (VDD_SOC), U201.U10 (VDD_DRAM), U201.U11 (VCC_GPU), U201.U17 (VDD_SOC), U201.U18 (VDD_SOC), U201.V12 (VCC_GPU), U201.W10 (VDD_DRAM), U201.W11 (VCC_GPU); also elsewhere on the board

Notes on the sheet:
QSPI boot by default, press button changes to eMMC boot (invalid) so it should fallback to USB
0201
PLL
VDDQ
0402
NVCC PVCC
PLL ANA
XTAL

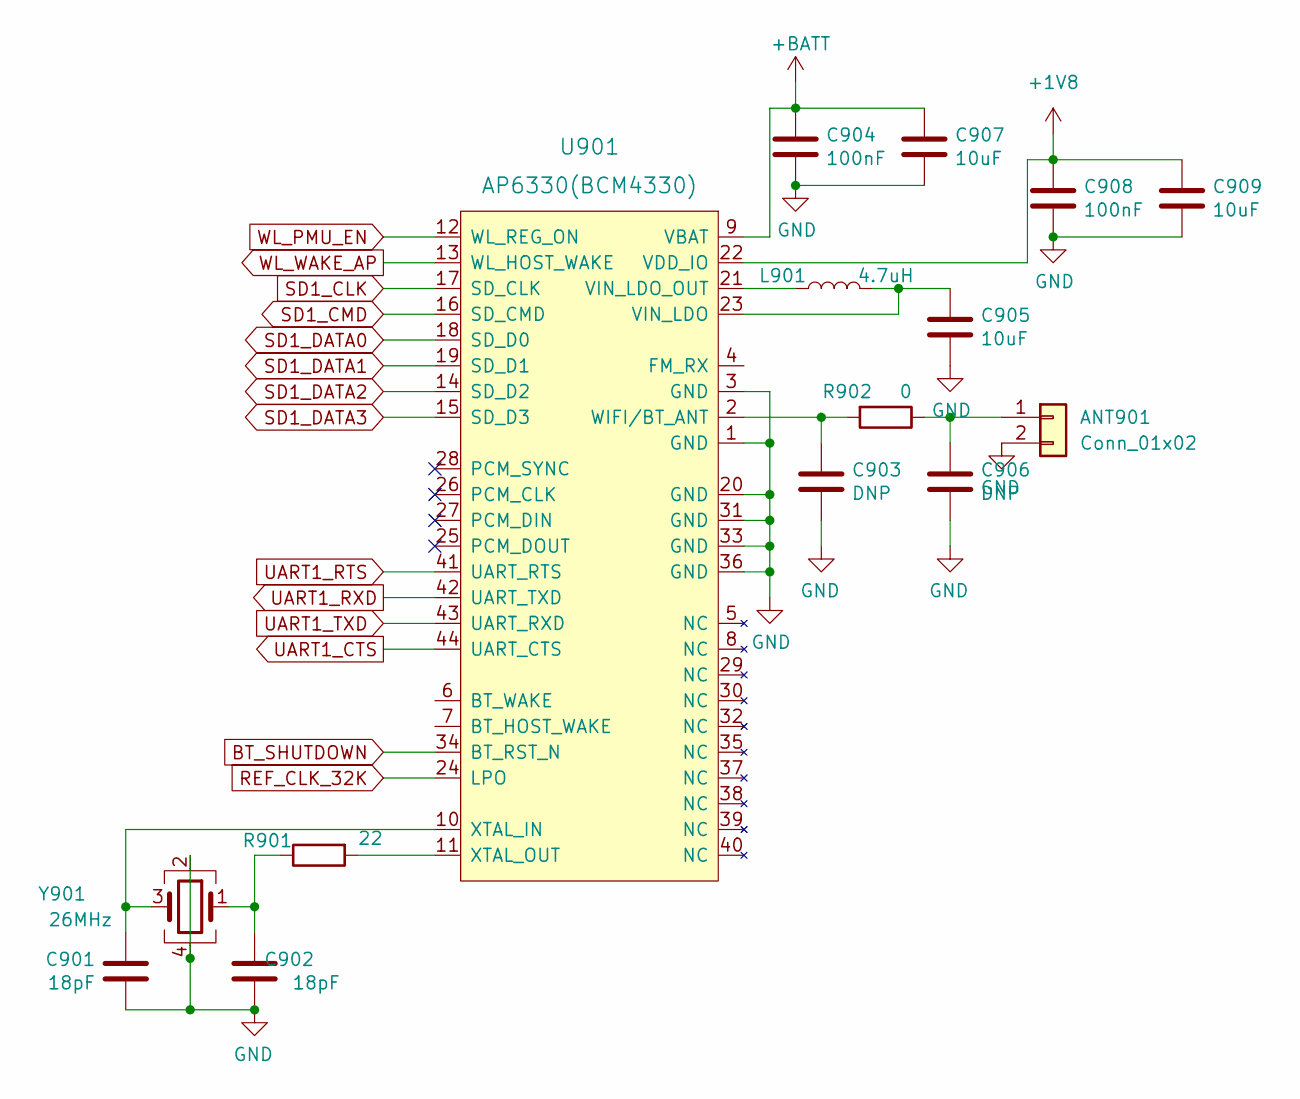
[picture p10: schematic wifibt.kicad_sch, Sharket]

Parts:
ANT901: Conn_01x02; Texas_SWRA117D_2.4GHz_Right
C901, C902: 18pF; C_0402_1005Metric
C903, C906: DNP; C_0402_1005Metric
C904, C908: 100nF; C_0201_0603Metric
C905, C907, C909: 10uF; C_0603_1608Metric
L901: 4.7uH; L_1210_3225Metric
R901: 22; R_0402_1005Metric
R902: 0; R_0402_1005Metric
U901: AP6330(BCM4330); RL-SM02BD(RTL8723BS)
Y901: 26MHz; Oscillator_SMD_Abracon_ASE-4Pin_3.2x2.5mm

Connections:
+1V8: C908.1, C909.1, U901.22 (VDD_IO); also elsewhere on the board
+BATT: C904.1, C907.1, U901.9 (VBAT); also elsewhere on the board
BT_SHUTDOWN: U901.34 (BT_RST_N); also elsewhere on the board
GND: ANT901.2, C901.2, C902.2, C903.1, C904.2, C905.2, C906.1, C907.2, C908.2, C909.2, U901.1 (GND), U901.3 (GND), U901.20 (GND), U901.31 (GND), U901.33 (GND), U901.36 (GND), Y901.2, Y901.4; also elsewhere on the board
unnamed: ANT901.1, C906.2, R902.1
unnamed: C902.1, R901.1, Y901.1
unnamed: C905.1, L901.2, U901.23 (VIN_LDO)
unnamed: L901.1, U901.21 (VIN_LDO_OUT)
unnamed: C903.2, R902.2, U901.2 (WIFI/BT_ANT)
unnamed: C901.1, U901.10 (XTAL_IN), Y901.3
unnamed: R901.2, U901.11 (XTAL_OUT)
REF_CLK_32K: U901.24 (LPO); also elsewhere on the board
SD1_CLK: U901.17 (SD_CLK); also elsewhere on the board
SD1_CMD: U901.16 (SD_CMD); also elsewhere on the board
SD1_DATA0: U901.18 (SD_D0); also elsewhere on the board
SD1_DATA1: U901.19 (SD_D1); also elsewhere on the board
SD1_DATA2: U901.14 (SD_D2); also elsewhere on the board
SD1_DATA3: U901.15 (SD_D3); also elsewhere on the board
UART1_CTS: U901.44 (UART_CTS); also elsewhere on the board
UART1_RTS: U901.41 (UART_RTS); also elsewhere on the board
UART1_RXD: U901.42 (UART_TXD); also elsewhere on the board
UART1_TXD: U901.43 (UART_RXD); also elsewhere on the board
WL_PMU_EN: U901.12 (WL_REG_ON); also elsewhere on the board
WL_WAKE_AP: U901.13 (WL_HOST_WAKE); also elsewhere on the board

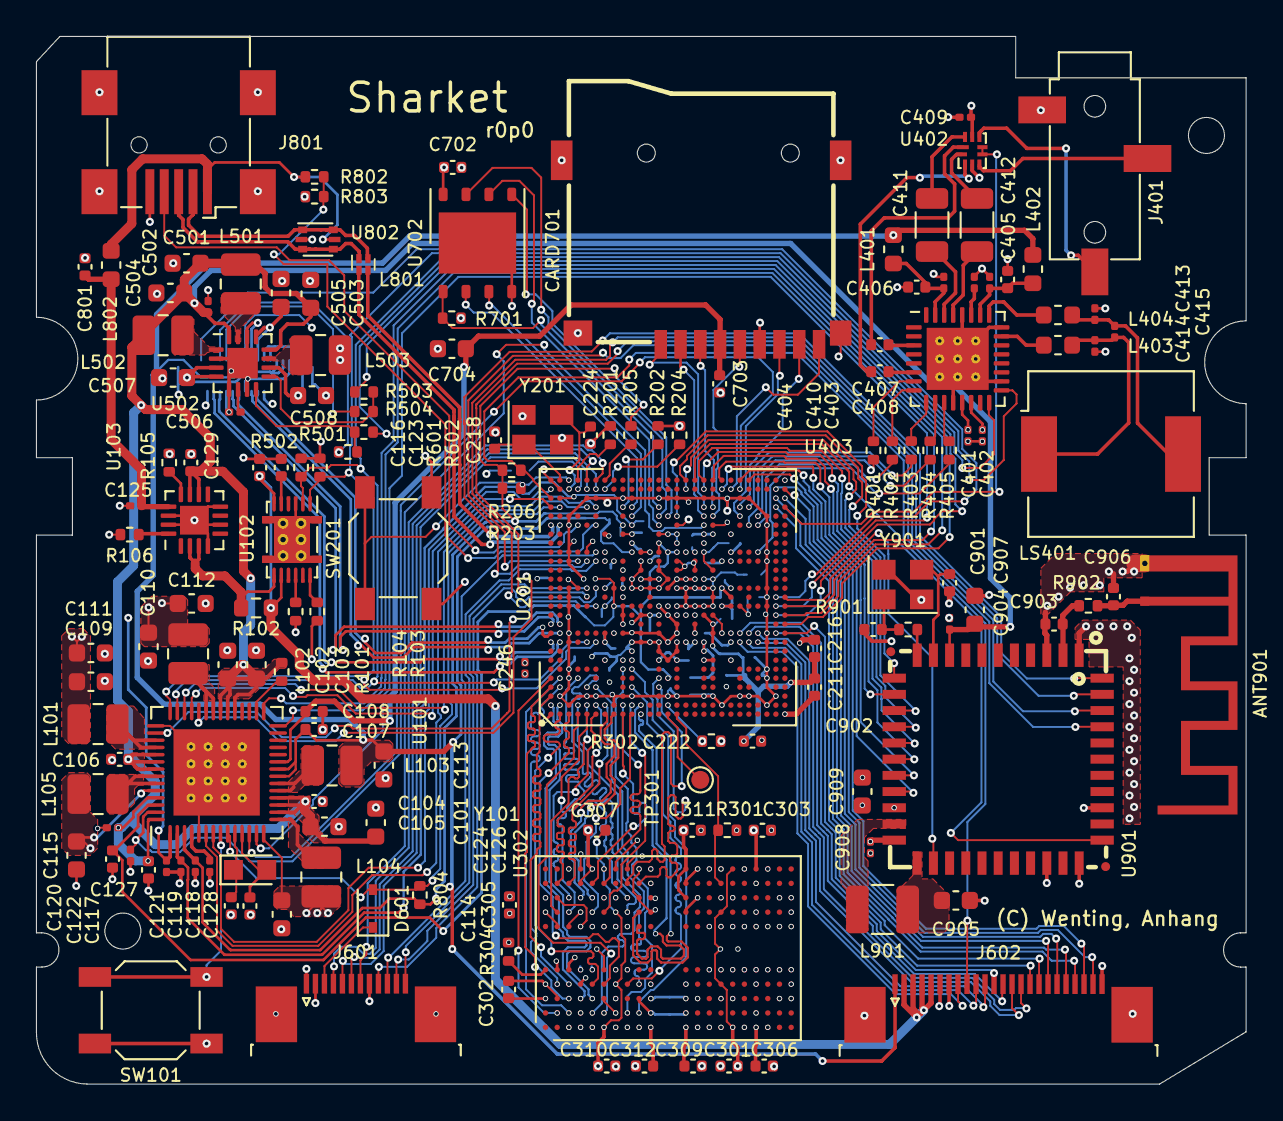
[picture p11: board pcb.kicad_pcb from above]

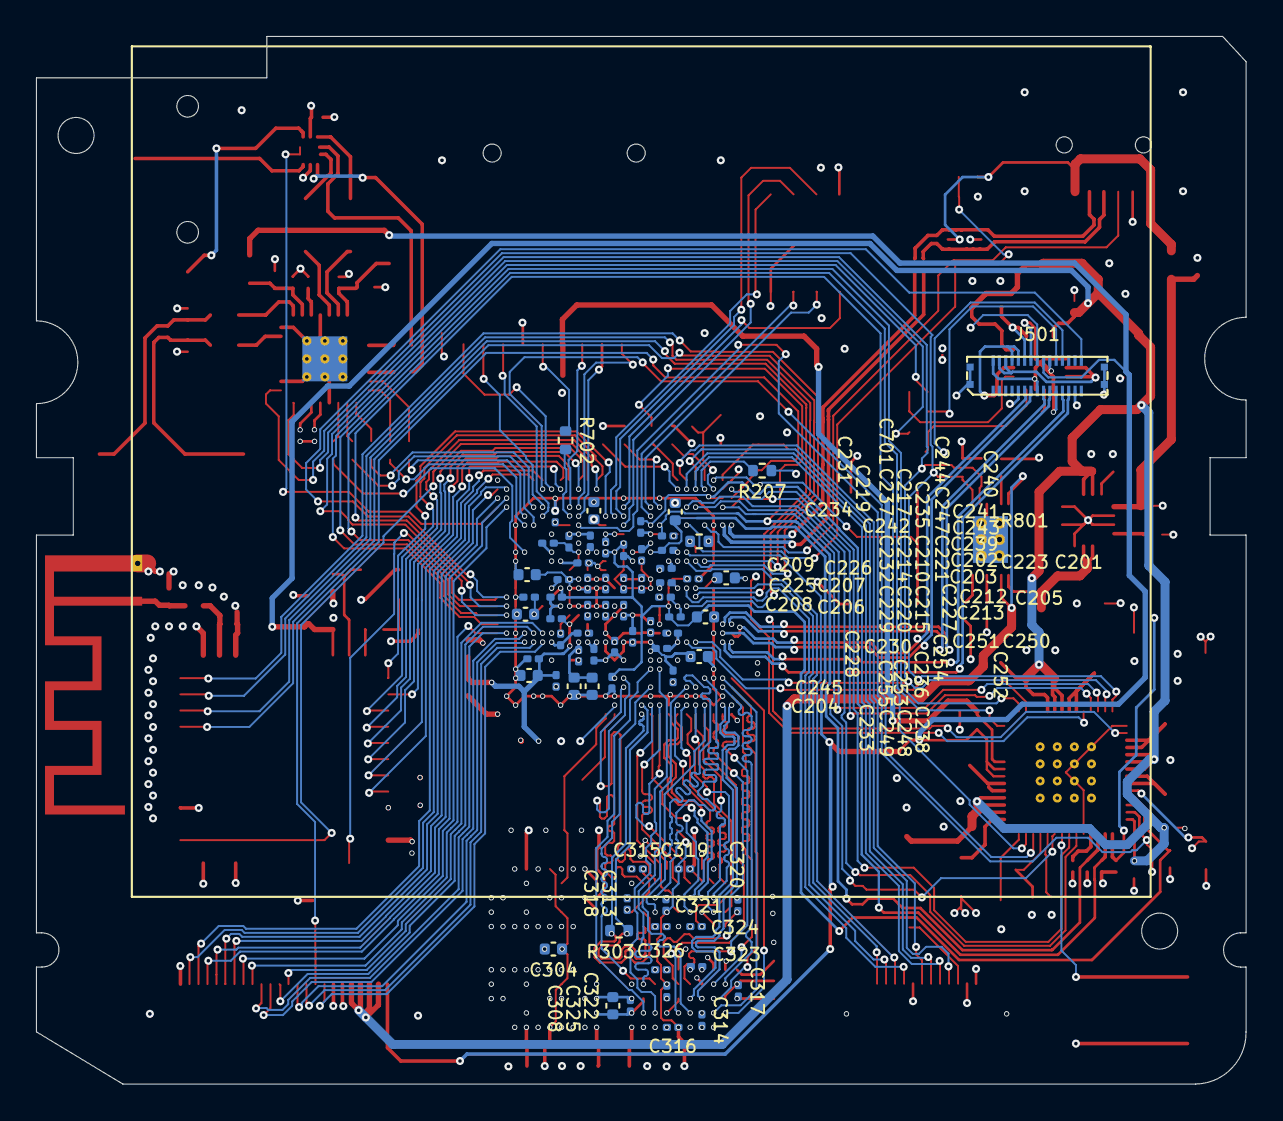
[picture p12: board pcb.kicad_pcb from below]

Board: 4 copper layers, 67.2 x 58.2 mm, 224 parts (71 on the bottom side), 204 nets.
