zephray/Sharket/pcb/keypad/keypad.kicad_pcb

## KiCad design pcb/keypad/keypad.kicad_pcb (2022-09-21)

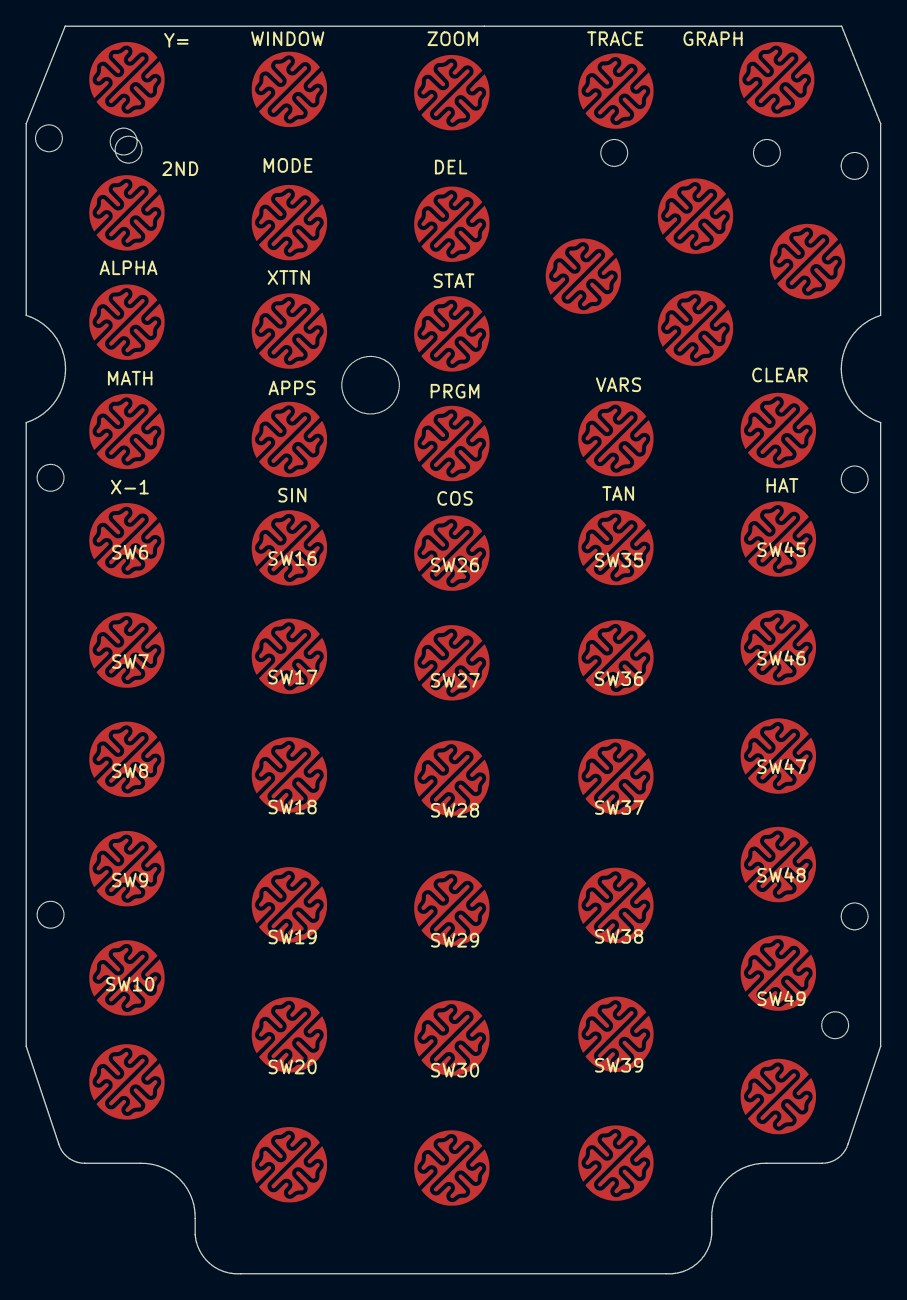
[picture p13: board keypad.kicad_pcb from above]

Board: 2 copper layers, 66.8 x 97.5 mm, 50 parts (0 on the bottom side), 15 nets, no tracks yet.

Parts:
SW1: Y=; key2
SW2: 2ND; key2
SW3: ALPHA; key2
SW4: MATH; key2
SW5: X-1; key2
SW6: X2; key2
SW7: LOG; key2
SW8: LN; key2
SW9: STO; key2
SW10: ON; key2
SW11: WINDOW; key2
SW12: MODE; key2
SW13: XTTN; key2
SW14: APPS; key2
SW15: SIN; key2
SW16: COMMA; key2
SW17: 7; key2
SW18: 4; key2
SW19: 1; key2
SW20: 0; key2
SW21: ZOOM; key2
SW22: DEL; key2
SW23: STAT; key2
SW24: PRGM; key2
SW25: COS; key2
SW26: LBRACKET; key2
SW27: 8; key2
SW28: 5; key2
SW29: 2; key2
SW30: DOT; key2
SW31: L; key2
SW32: TRACE; key2
SW33: VARS; key2
SW34: TAN; key2
SW35: RBRACKET; key2
SW36: 9; key2
SW37: 6; key2
SW38: 3; key2
SW39: NEG; key2
SW40: U; key2
SW41: D; key2
SW42: GRAPH; key2
SW43: CLEAR; key2
SW44: HAT; key2
SW45: DIV; key2
SW46: MUL; key2
SW47: SUB; key2
SW48: ADD; key2
SW49: ENTER; key2
SW50: R; key2

Connections:
/Keys/KC0: SW1.2, SW2.2, SW11.2, SW12.2, SW21.2, SW22.1, SW32.2, SW42.2
/Keys/KC1: SW3.1, SW4.1, SW5.1, SW6.1, SW7.1, SW8.1, SW9.1
/Keys/KC2: SW13.1, SW14.1, SW15.1, SW16.1, SW17.1, SW18.1, SW19.1, SW20.1
/Keys/KC3: SW23.1, SW24.1, SW25.1, SW26.1, SW27.1, SW28.1, SW29.1, SW30.1
/Keys/KC4: SW33.1, SW34.1, SW35.1, SW36.1, SW37.1, SW38.1, SW39.1
/Keys/KC5: SW43.1, SW44.1, SW45.1, SW46.1, SW47.1, SW48.1, SW49.1
/Keys/KC6: SW31.2, SW40.2, SW41.1, SW50.1
/Keys/KR0: SW20.2, SW30.2, SW39.2, SW41.2, SW42.1, SW49.2
/Keys/KR1: SW9.2, SW19.2, SW29.2, SW31.1, SW32.1, SW38.2, SW48.2
/Keys/KR2: SW8.2, SW18.2, SW21.1, SW28.2, SW37.2, SW47.2, SW50.2
/Keys/KR3: SW7.2, SW11.1, SW17.2, SW27.2, SW36.2, SW40.1, SW46.2
/Keys/KR4: SW1.1, SW6.2, SW16.2, SW26.2, SW35.2, SW45.2
/Keys/KR5: SW2.1, SW5.2, SW15.2, SW25.2, SW34.2, SW44.2
/Keys/KR6: SW4.2, SW12.1, SW14.2, SW24.2, SW33.2, SW43.2
unnamed: SW3.2, SW13.2, SW22.2, SW23.2
