zephray/Sharket/(commit log)

2022-09-21 Keypad Layout v0
    [keypad.kicad_pcb, keypad.kicad_sch, keypad_keys.kicad_sch]
2022-09-21 Mainboard sch initial commit, wip
    [audio.kicad_sch, fpga.kicad_sch, keypad.kicad_sch, lcd.kicad_sch, mcu.kicad_sch, microsd.kicad_sch, pcb.kicad_pcb, pcb.kicad_sch]
2022-09-22 Working on mainboard schematics
    [keypad.kicad_sch, lcd.kicad_sch, mcu.kicad_sch, microsd.kicad_sch, pcb.kicad_sch, power.kicad_sch, ram.kicad_sch, usb.kicad_sch]
2022-09-23 Keypad Layout Done V1
    [keypad.kicad_sch, keypad_keys.kicad_sch]
2022-09-23 Mainboard schematics WIP
    [audio.kicad_sch, keypad.kicad_sch, lcd.kicad_sch, mcu.kicad_sch, microsd.kicad_sch, pcb.kicad_pcb, pcb.kicad_sch, power.kicad_sch]
2022-09-24 Draft motherboard schematics for r0.0 layout
    [audio.kicad_sch, keypad.kicad_sch, mcu.kicad_sch, microsd.kicad_sch, pcb.kicad_pcb, pcb.kicad_sch, power.kicad_sch, ram.kicad_sch]
2022-09-24 Keypad Schematic Update - Comm Interface
    [keypad.kicad_sch]
2022-09-24 Motherboard PCB component initial placement, schematics fixes
    [audio.kicad_sch, keypad.kicad_sch, mcu.kicad_sch, microsd.kicad_sch, pcb.kicad_pcb, pcb.kicad_sch, power.kicad_sch, ram.kicad_sch]
2022-09-26 Routing mainboard in progress, schematics fixes
    [audio.kicad_sch, keypad.kicad_sch, mcu.kicad_sch, microsd.kicad_sch, pcb.kicad_pcb, pcb.kicad_sch, ram.kicad_sch, usb.kicad_sch]
2022-09-27 Keypad Layout Update - JTAG/UART
    [keypad.kicad_sch]
2022-10-03 Update layout
    [pcb.kicad_pcb]
2022-10-03 Minor - Layout wifi antenna
    [pcb.kicad_pcb]
2022-10-04 Mainboard design bug fixes
    [mcu.kicad_sch, pcb.kicad_pcb, pcb.kicad_sch, power.kicad_sch]
2023-03-07 Keypad bugfix, pulling in submodules
    [audio.kicad_sch, keypad.kicad_sch, keypad_keys.kicad_sch, lcd.kicad_sch, mcu.kicad_sch, microsd.kicad_sch, pcb.kicad_pcb, pcb.kicad_sch]
