zephray/Sharket/(notices)

Notices in the files:
pcb/mainboard/wifibt.kicad_sch:
This source describes Open Hardware and is licensed under the CERN-OHL-P v2.
